metehankk/MeteK-EE463_Project/Case/case.png

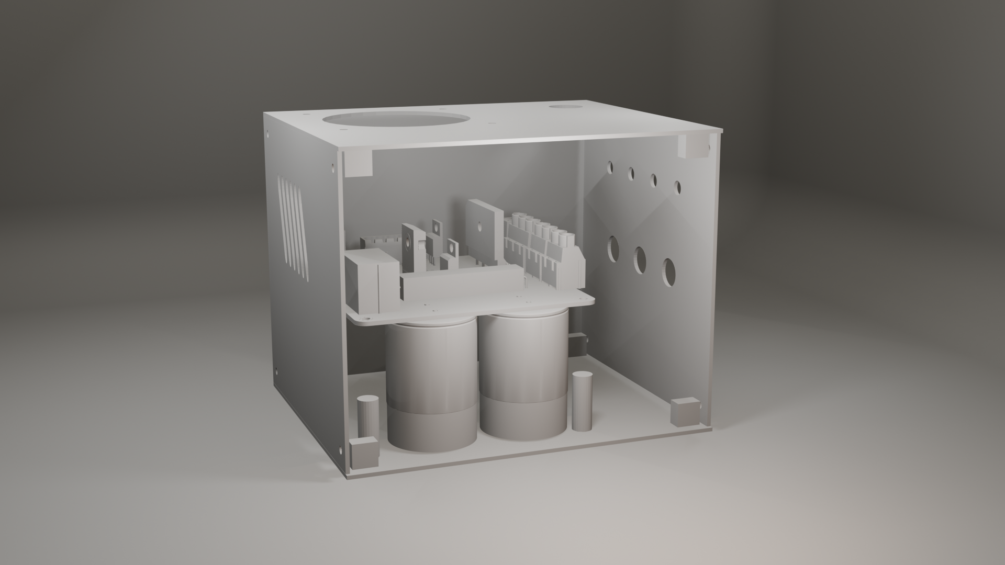
Case/case.png
