metehankk/MeteK-EE463_Project/Reports/Presentation/EE463.pdf

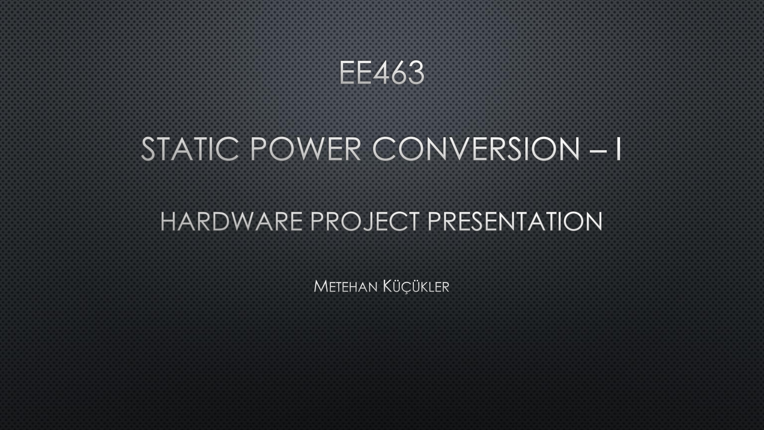
[picture p20: page 1]

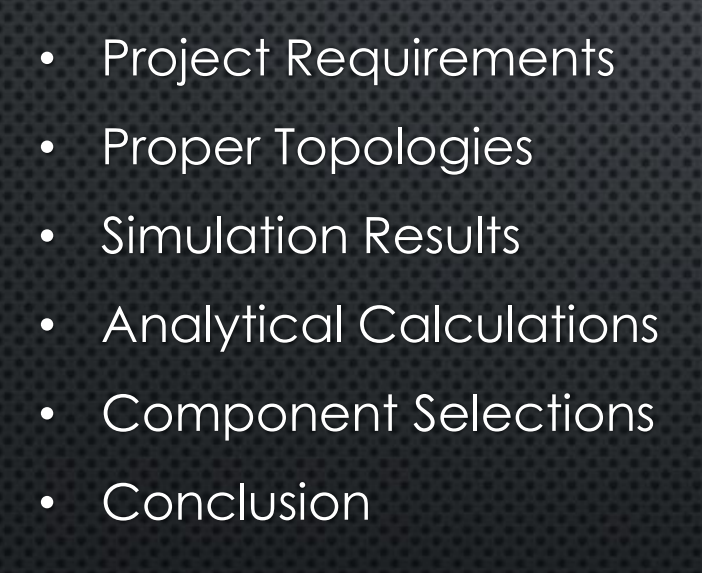
[picture p21: figure]
• Project Requirements; • Proper Topologies; • Simulation Results; • Analytical Calculations; • Component Selections; • Conclusion
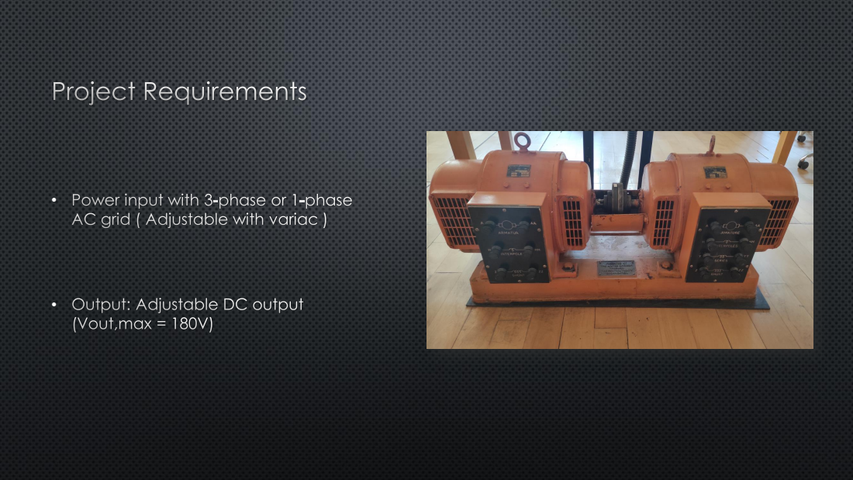
[picture p22: page 3]

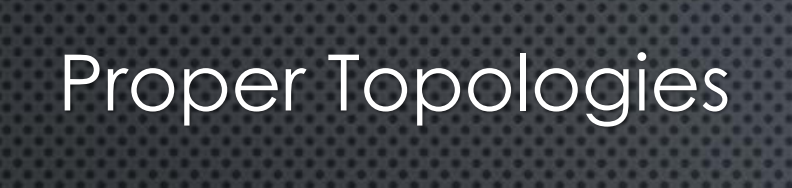
[picture p23: figure]
Proper Topologies
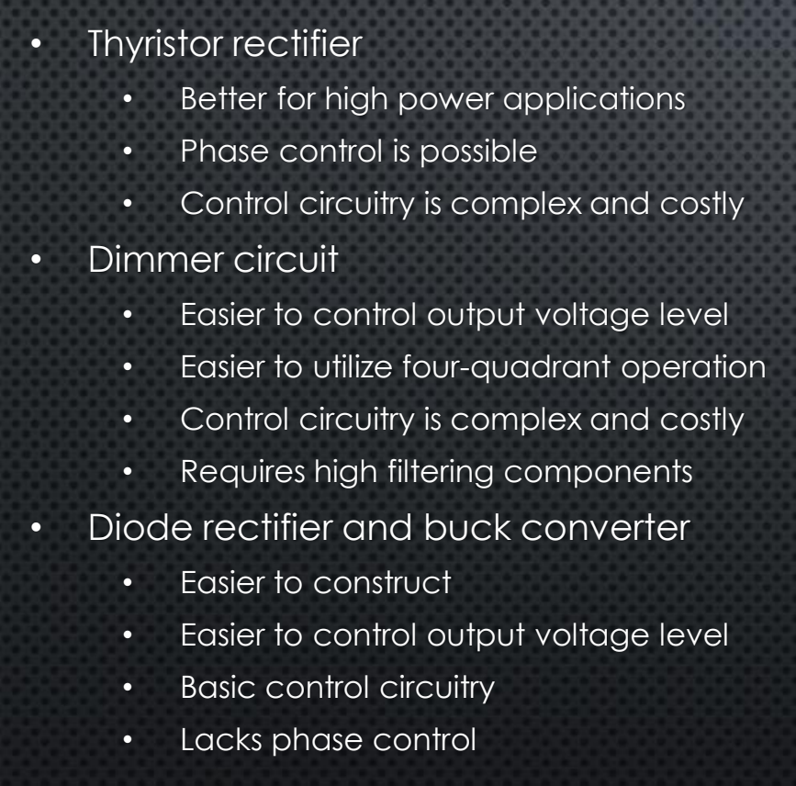
[picture p24: figure]
• Thyristor rectifier; • Better for high power applications; • Phase control is possible; • Dimmer circuit; • Requires high filtering components; • Diode rectifier and buck converter; • Easier to construct; • Basic control circuitry; • Lacks phase control

- Control circuitry is complex and costly
- Easier to control output voltage level
- Easier to utilize four-quadrant operation
- Control circuitry is complex and costly
- Easier to control output voltage level

## Selected Topology

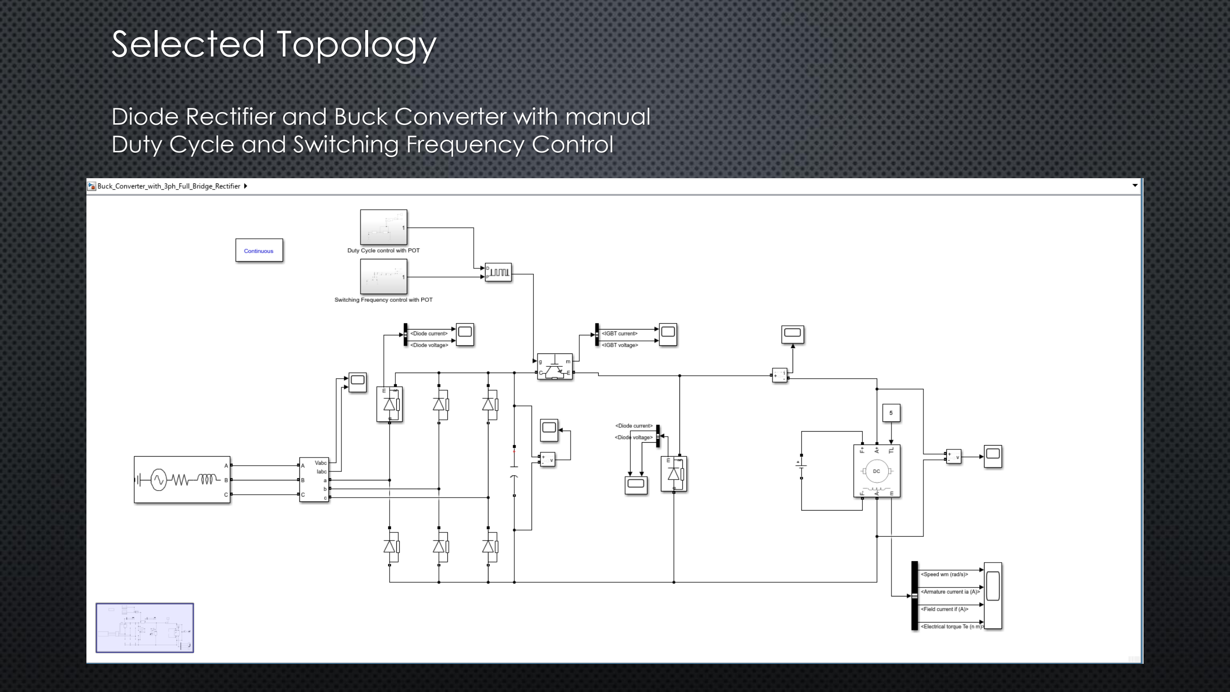
[picture p25: page 5]

Diode Rectifier and Buck Converter with manual Duty Cycle and Switching Frequency Control

## Simulation Results(with RL load)

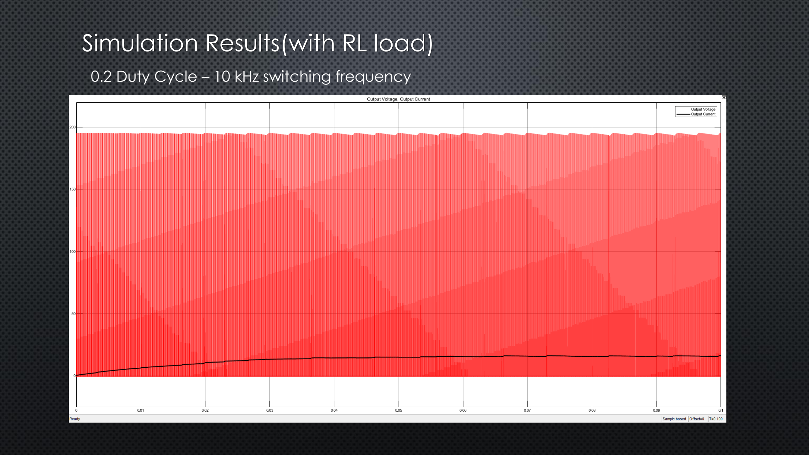
[picture p26: page 6]

0.2 Duty Cycle – 10 kHz switching frequency

## Simulation Results(with RL load)

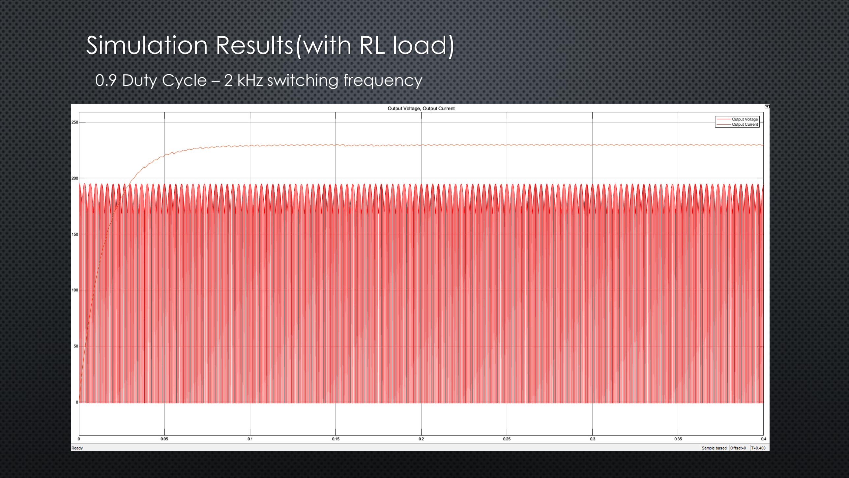
[picture p27: page 7]

0.9 Duty Cycle – 2 kHz switching frequency

## Analytical Calculations

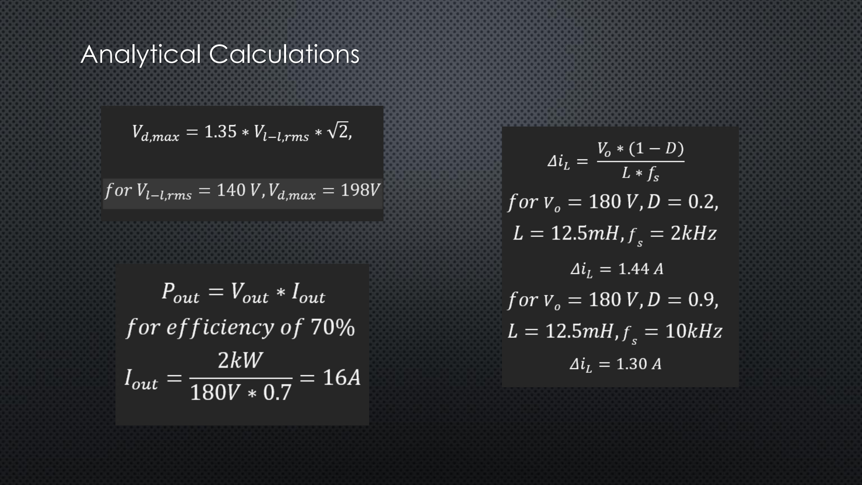
[picture p28: page 8]

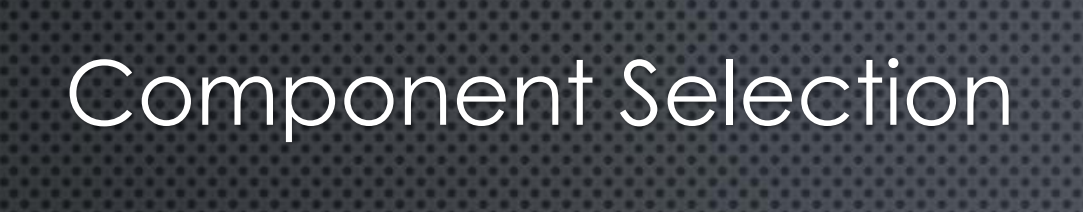
[picture p29: figure]
Component Selection

IGBT | >400V | >25A
RECTIFIER | >400V | >25A
CAPACITOR | 400V | 3 x 470μF
POTENTIOMETER | | 1-100kΩ
Fast Diode | >400V | >25A

Microcontroller Raspberry Pi Pico

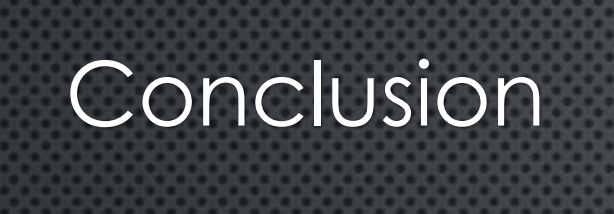
[picture p30: figure]
Conclusion

- Testing
- Integration
- PCB Design
