metehankk/MeteK-EE463_Project/Reports/Final report/Figures/cap.png

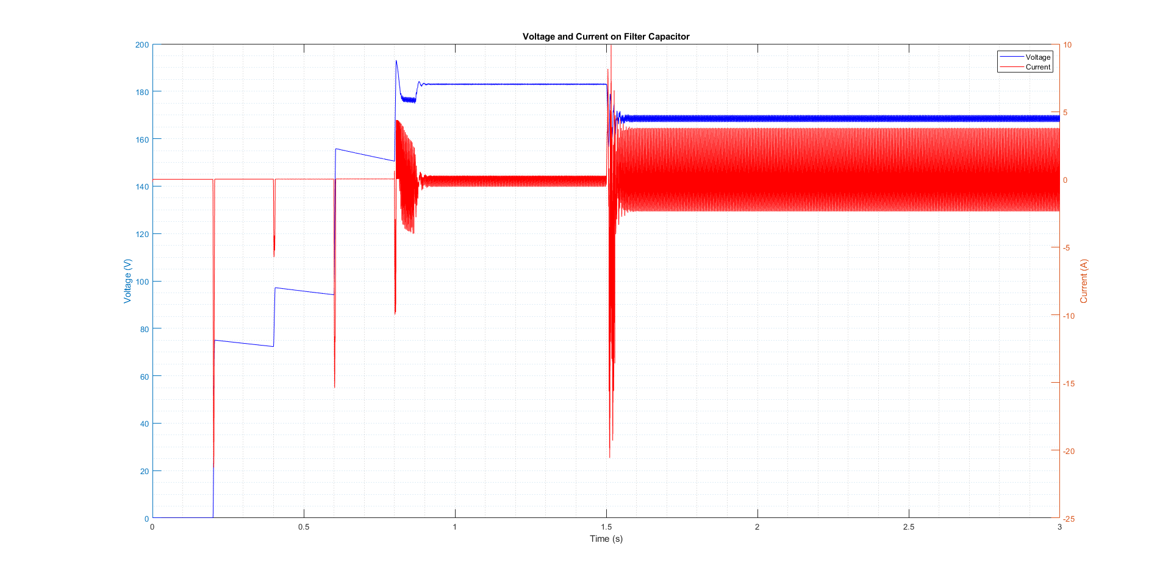
Reports/Final report/Figures/cap.png
