metehankk/MeteK-EE463_Project/Reports/Final report/Figures/fwdiode.png

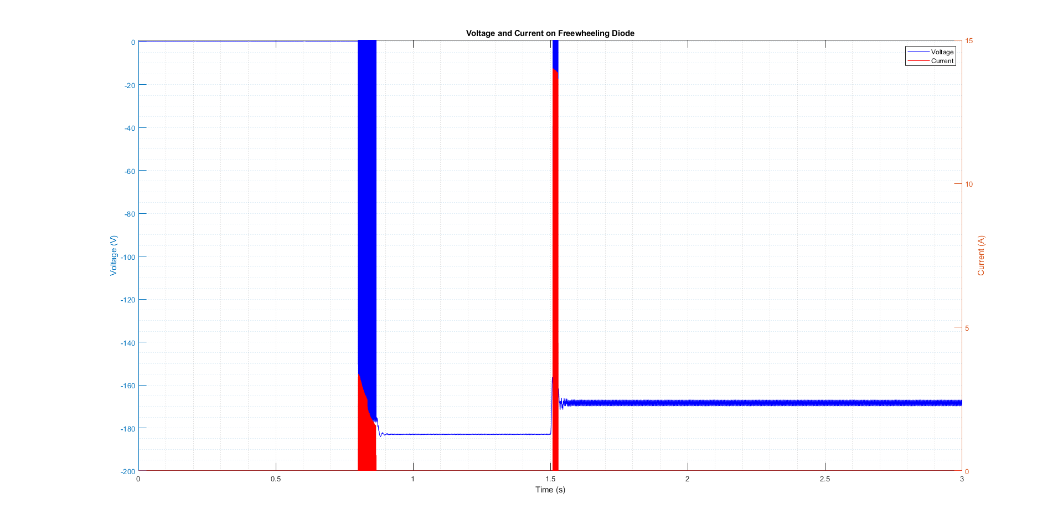
Reports/Final report/Figures/fwdiode.png
