metehankk/MeteK-EE463_Project/Reports/Final report/Figures/igbt.png

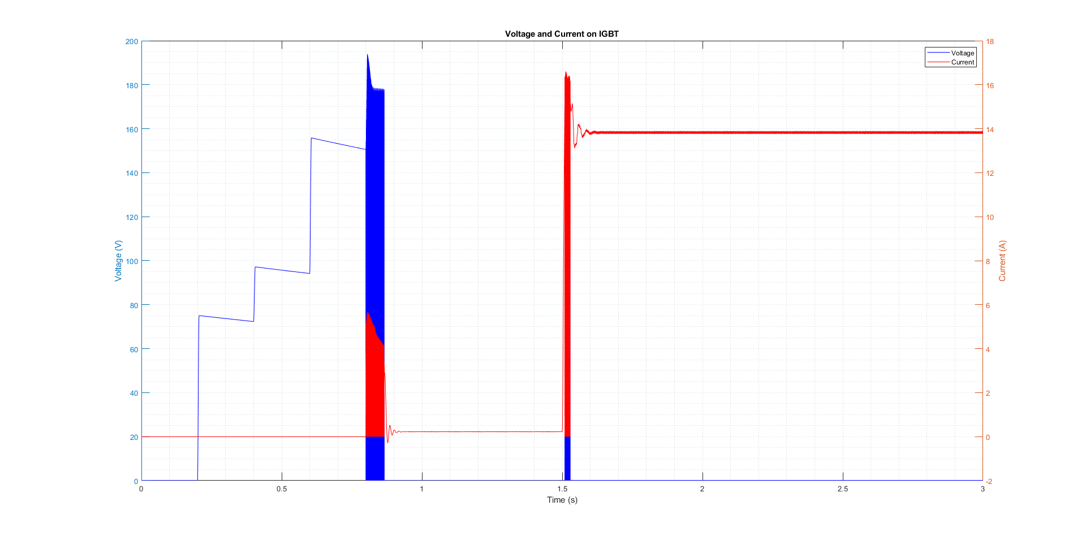
Reports/Final report/Figures/igbt.png
