metehankk/MeteK-EE463_Project/Reports/Final report/Figures/input.png

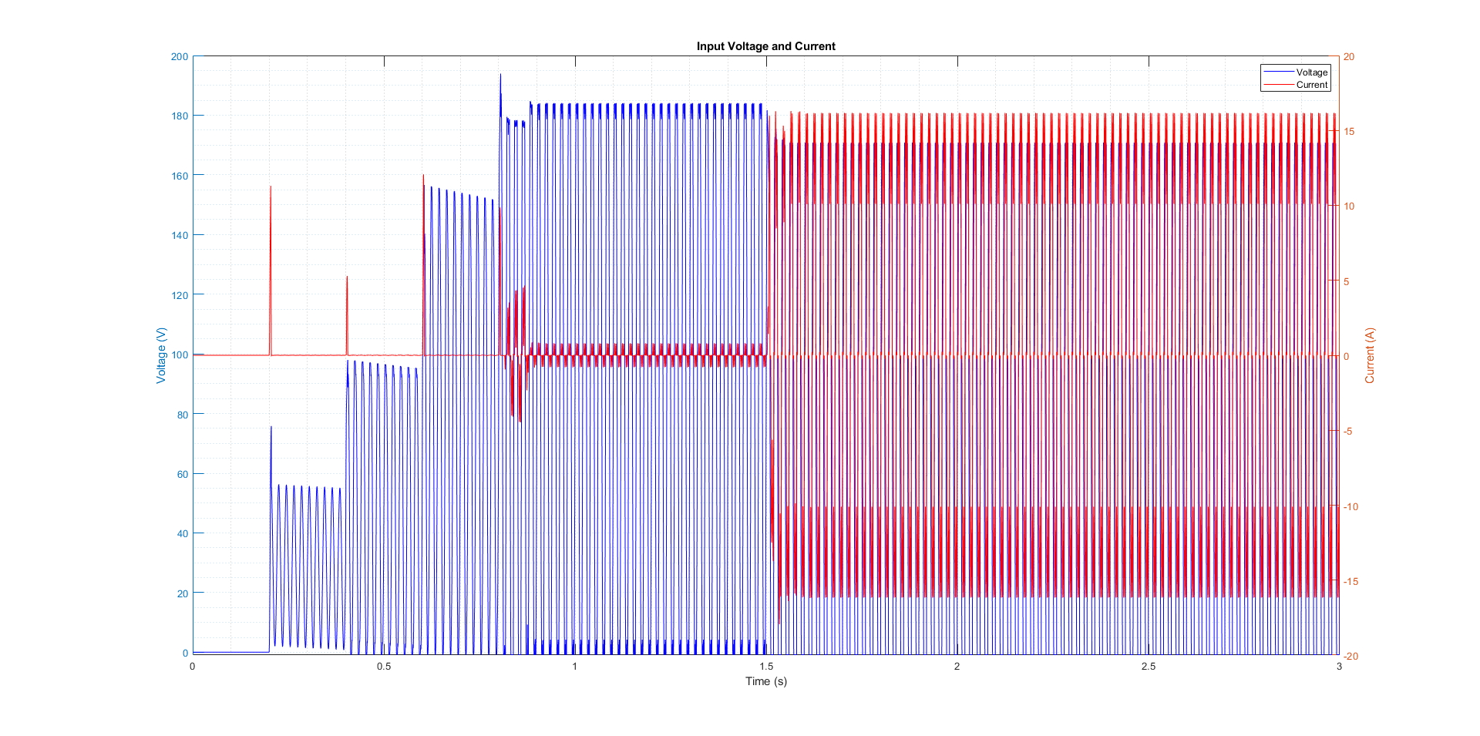
Reports/Final report/Figures/input.png
