metehankk/MeteK-EE463_Project/Reports/Final report/Figures/inputss.png

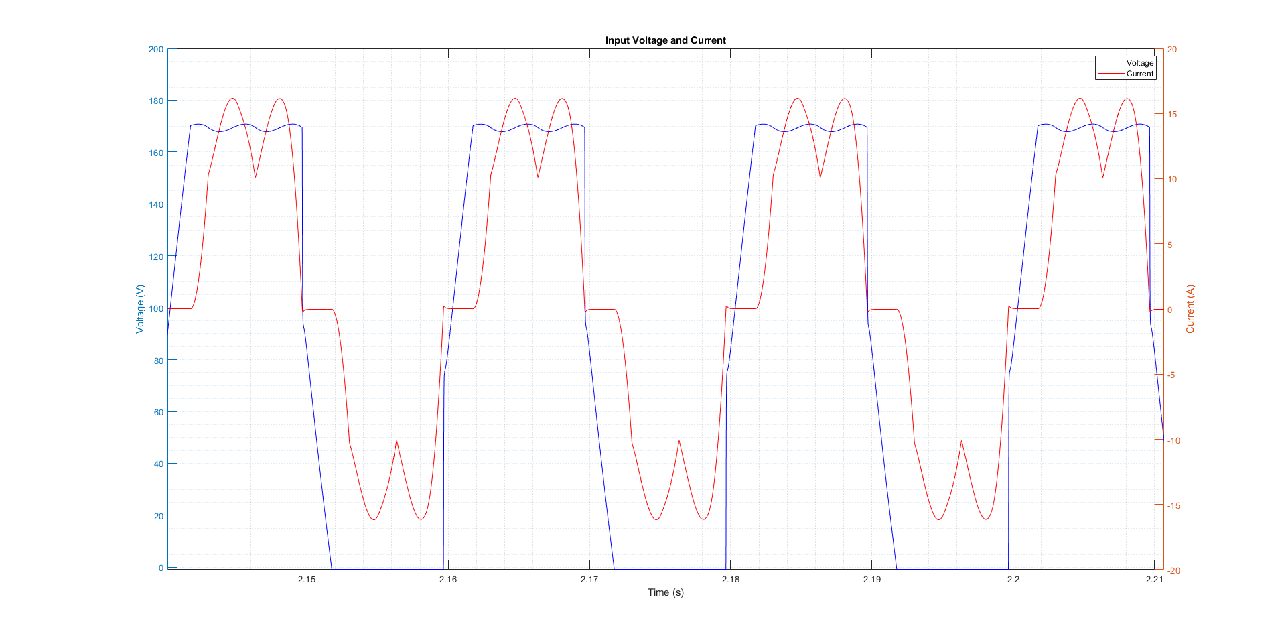
Reports/Final report/Figures/inputss.png
