metehankk/MeteK-EE463_Project/Reports/Final report/Figures/machine.png

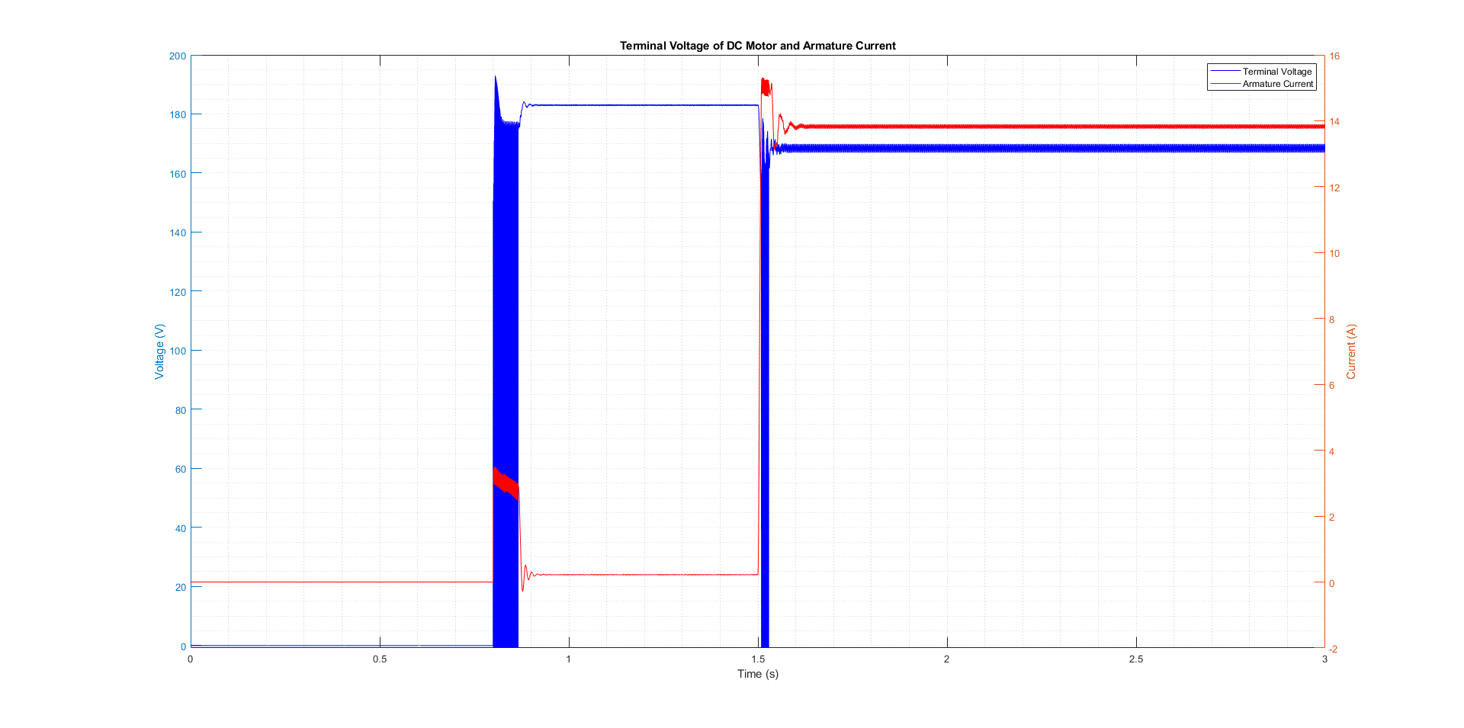
Reports/Final report/Figures/machine.png
