metehankk/MeteK-EE463_Project/Reports/Final report/Figures/machiness.png

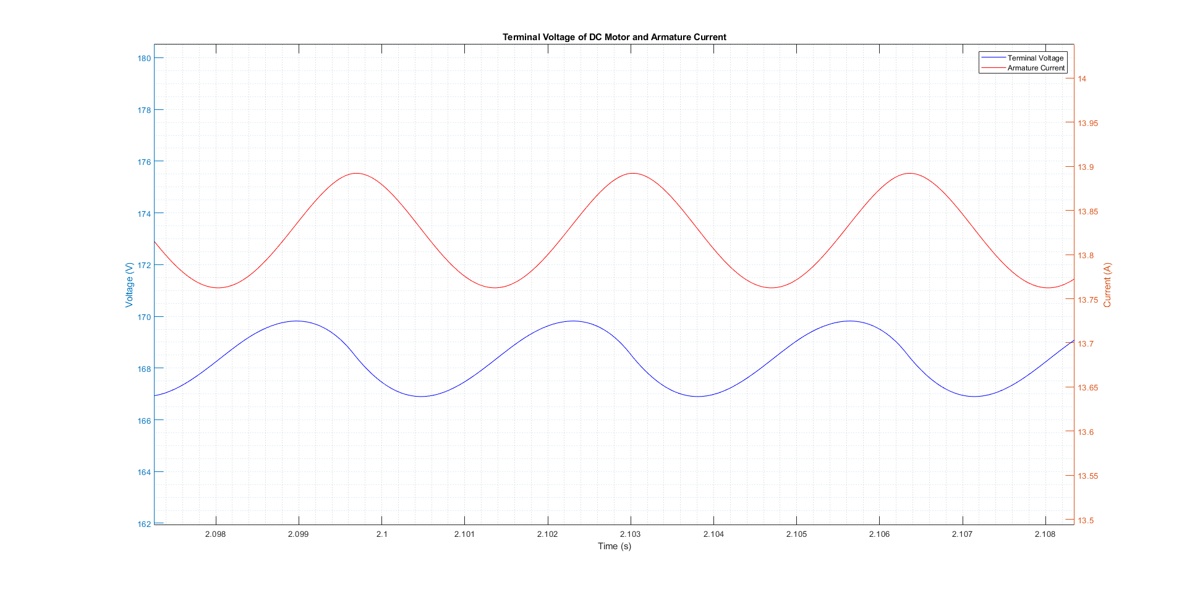
Reports/Final report/Figures/machiness.png
