metehankk/MeteK-EE463_Project/Reports/Final report/Figures/rec.png

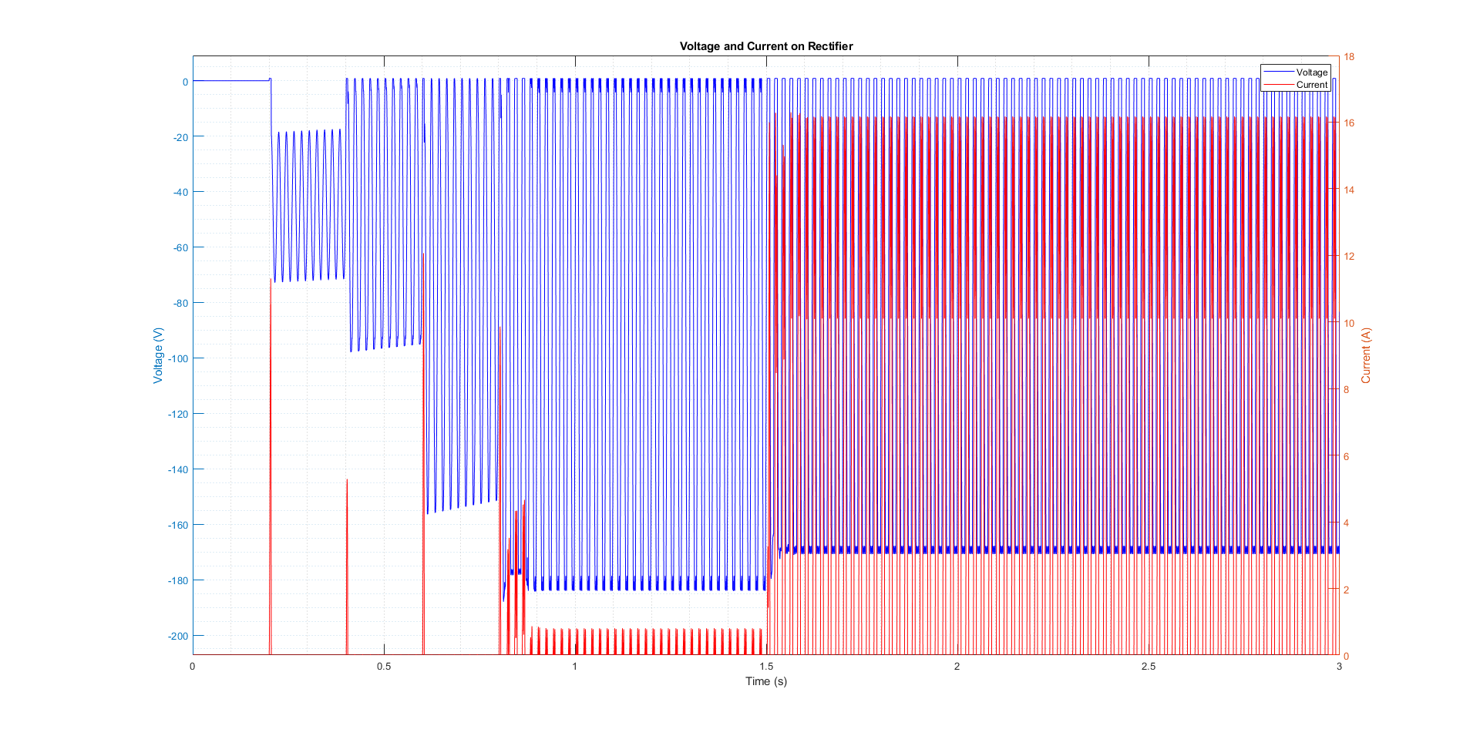
Reports/Final report/Figures/rec.png
