metehankk/MeteK-EE463_Project/Reports/Final report/Figures/speed.png

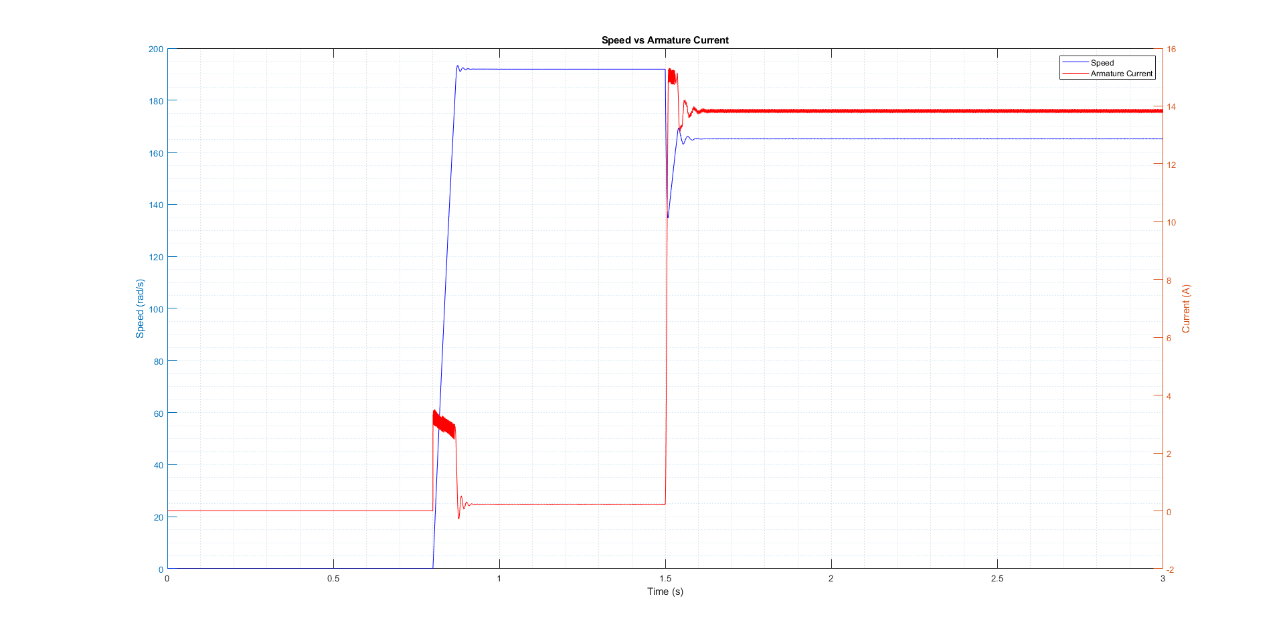
Reports/Final report/Figures/speed.png
