metehankk/MeteK-EE463_Project/Reports/Final report/Figures/speedss.png

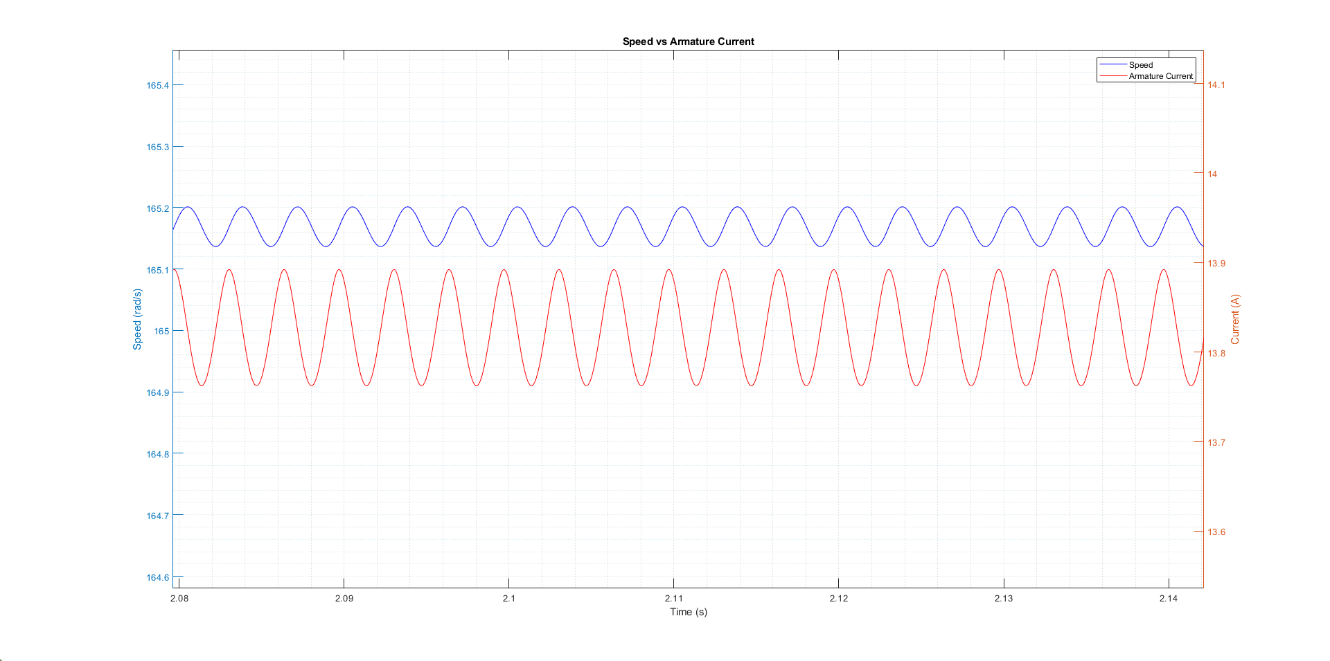
Reports/Final report/Figures/speedss.png
