metehankk/MeteK-EE463_Project/Reports/Presentation/Presentation-report-figures/Output-with-20D-10kHz.png

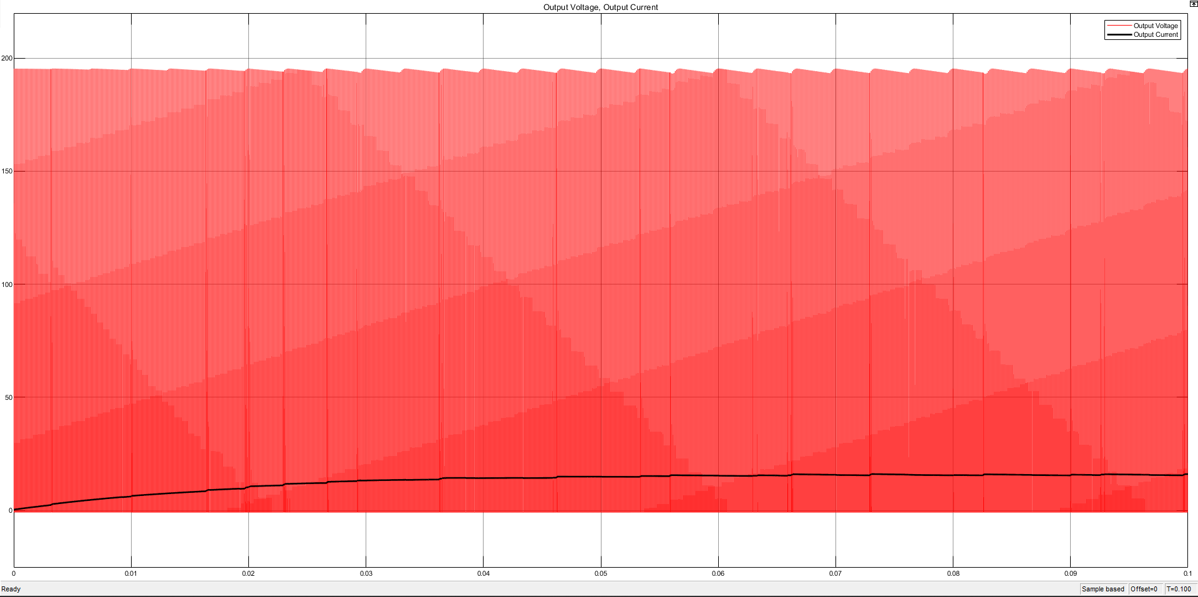
Reports/Presentation/Presentation-report-figures/Output-with-20D-10kHz.png
