metehankk/MeteK-EE463_Project/Reports/Presentation/Presentation-report-figures/Output-with-90D-2kHz.png

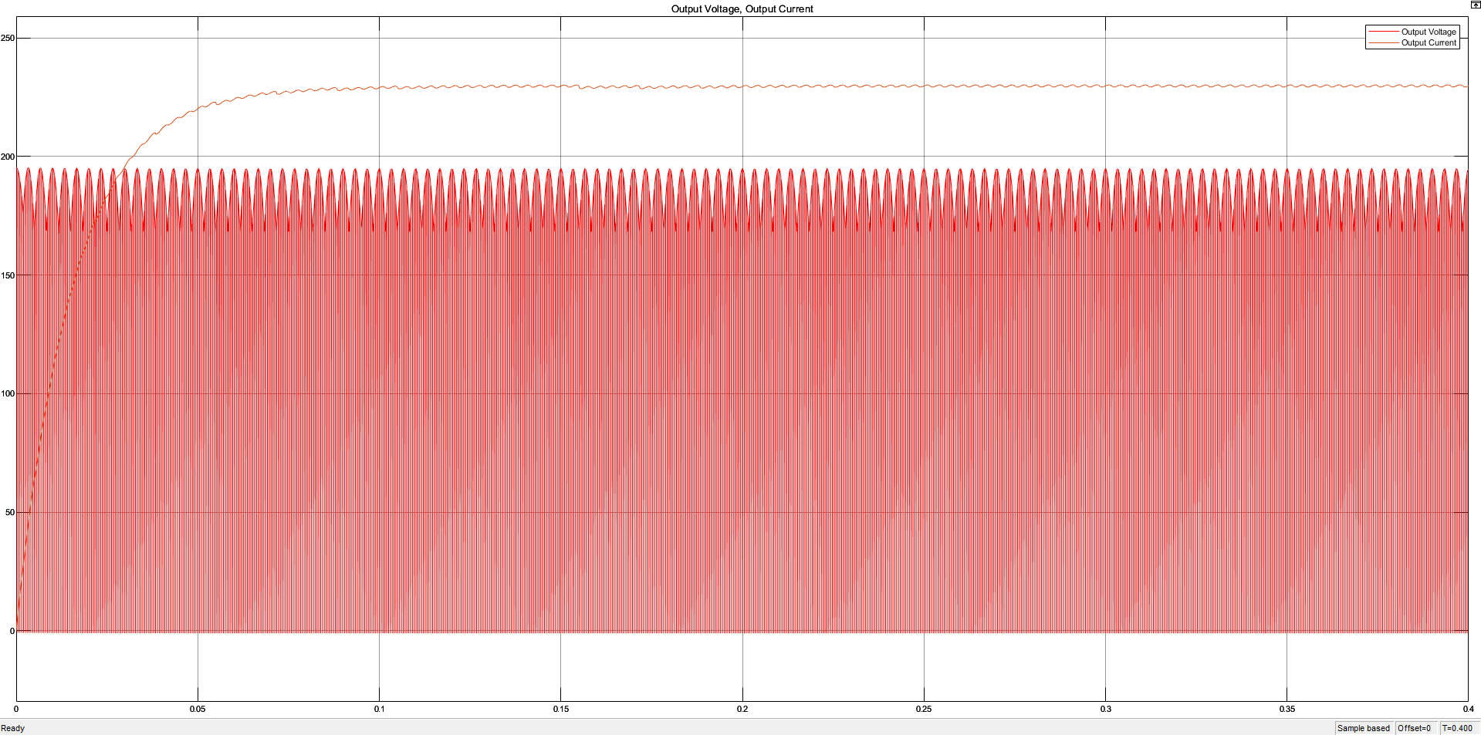
Reports/Presentation/Presentation-report-figures/Output-with-90D-2kHz.png
