metehankk/MeteK-EE463_Project/Reports/Simulation report/Simulation-report-figures/duty-cycle-cotrol.png

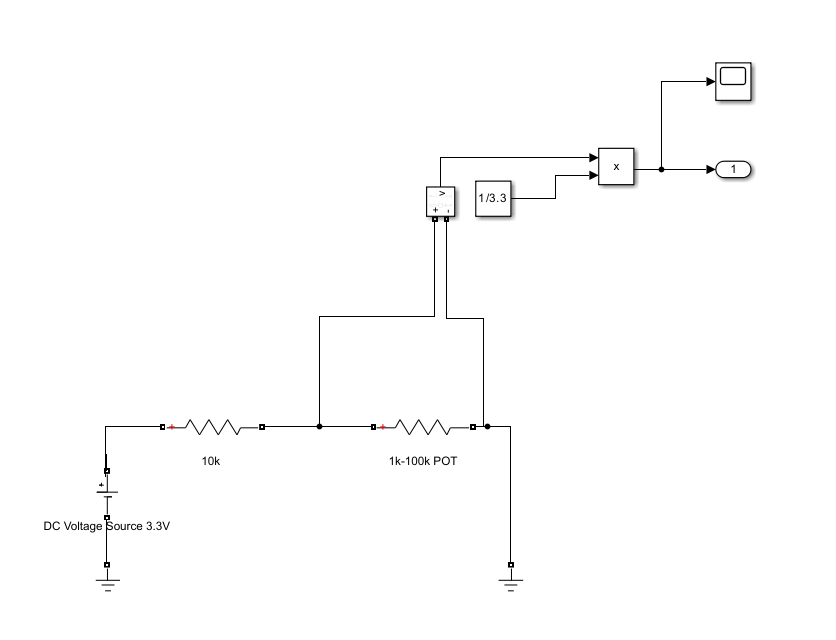
Reports/Simulation report/Simulation-report-figures/duty-cycle-cotrol.png
