metehankk/MeteK-EE463_Project/Reports/Simulation report/Simulation-report-figures/frequency-control.png

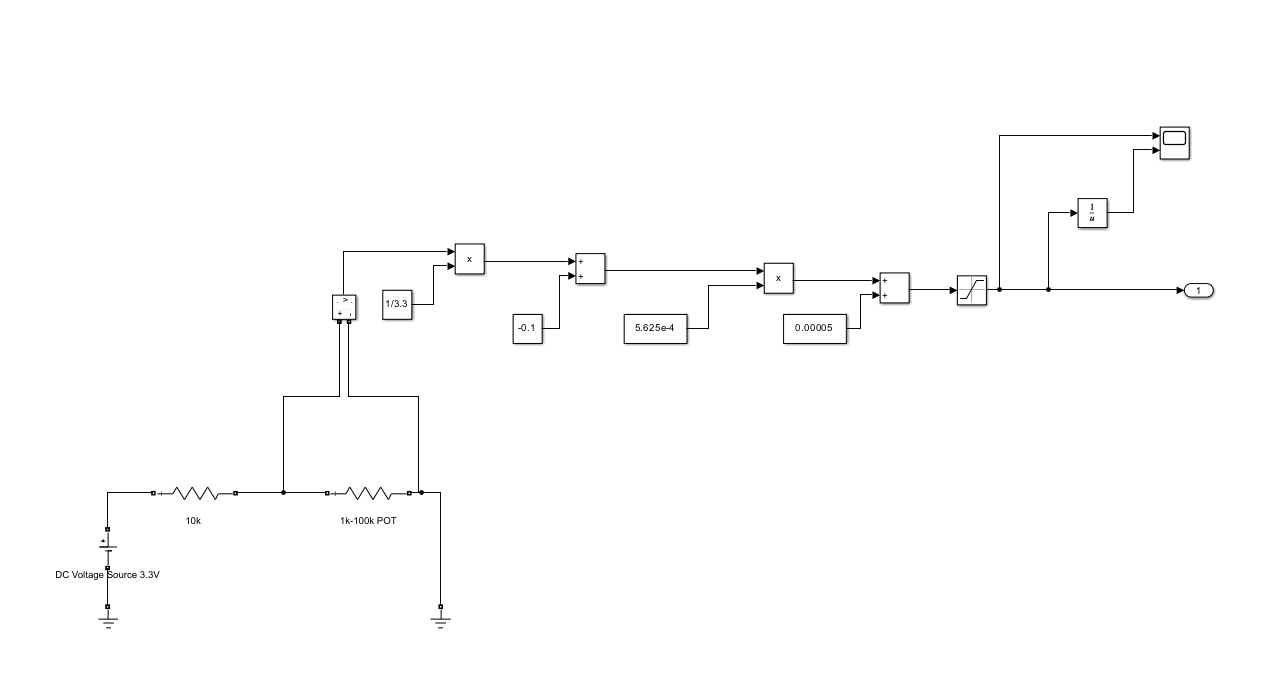
Reports/Simulation report/Simulation-report-figures/frequency-control.png
