metehankk/MeteK-EE463_Project/Reports/Simulation report/Simulation-report-figures/schematic-with-freq-and-d-control.png

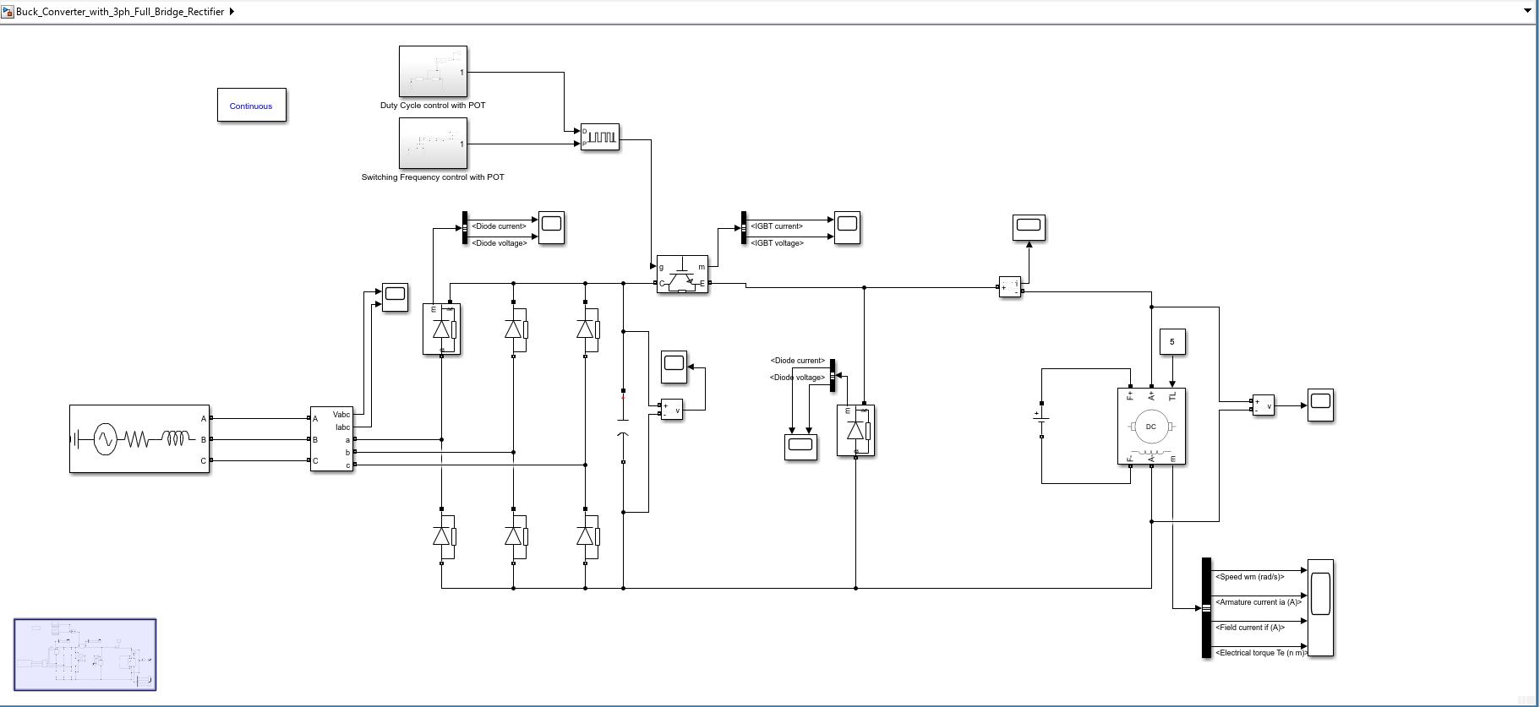
Reports/Simulation report/Simulation-report-figures/schematic-with-freq-and-d-control.png
