metehankk/MeteK-EE463_Project/Case/stl-exports/top.stl

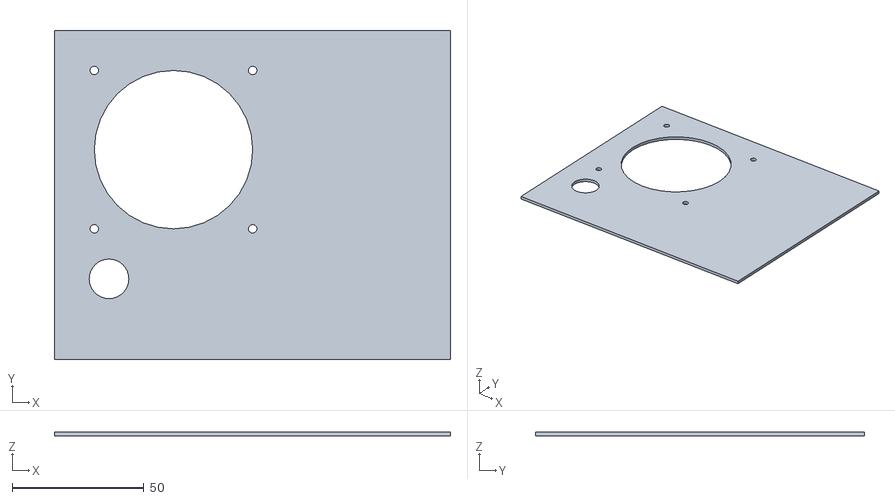
[picture p46: CAD file, 2023-01-24]
Case/stl-exports/top.stl
150.0 x 124.7 x 1.60
