metehankk/MeteK-EE463_Project/Case/stl-exports/pcb-mount.stl

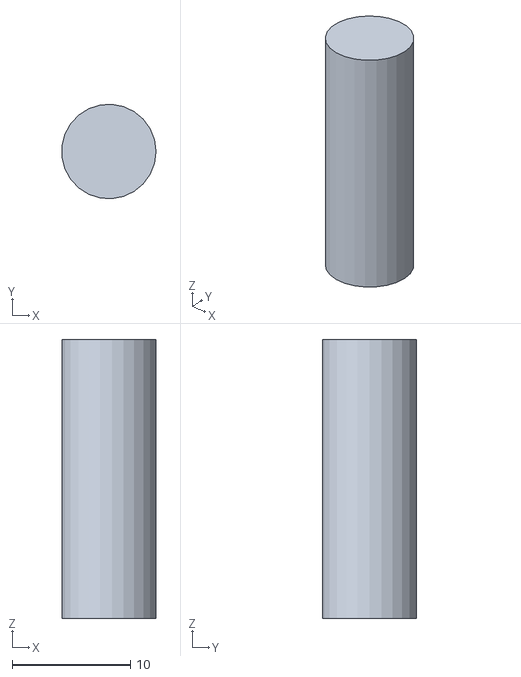
[picture p47: CAD file, 2023-01-05]
Case/stl-exports/pcb-mount.stl
7.97 x 7.98 x 23.6
