metehankk/MeteK-EE463_Project/Case/stl-exports/front.stl

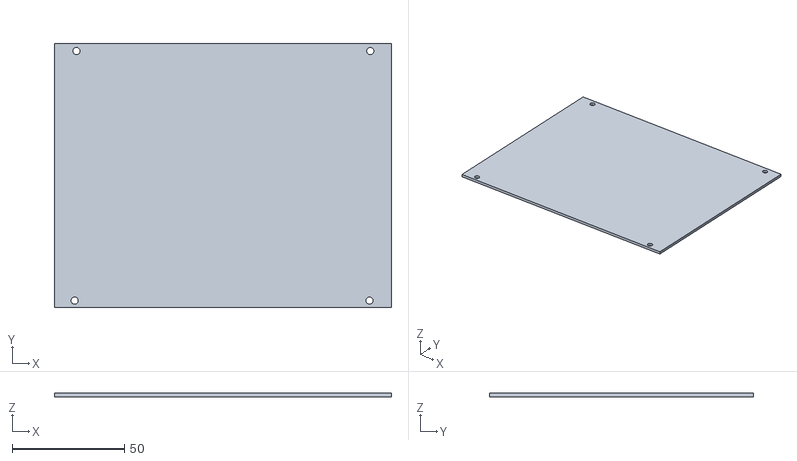
[picture p48: CAD file, 2023-01-05]
Case/stl-exports/front.stl
150.0 x 117.6 x 1.60
