metehankk/MeteK-EE463_Project/Case/stl-exports/right.stl

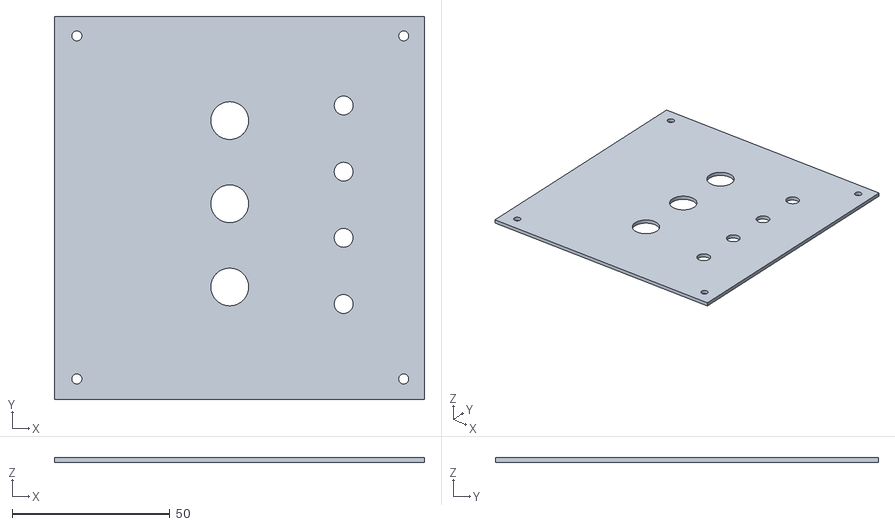
[picture p49: CAD file, 2023-01-05]
Case/stl-exports/right.stl
117.6 x 121.5 x 1.60
