metehankk/MeteK-EE463_Project/Case/stl-exports/bottom.stl

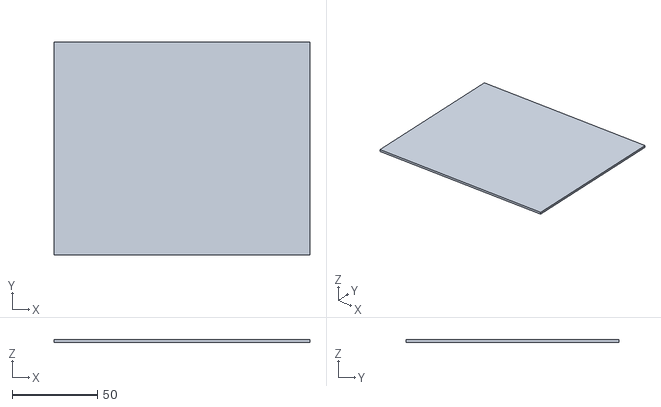
[picture p50: CAD file, 2023-01-05]
Case/stl-exports/bottom.stl
150.0 x 124.7 x 1.60
