metehankk/MeteK-EE463_Project/Case/stl-exports/cubes.stl

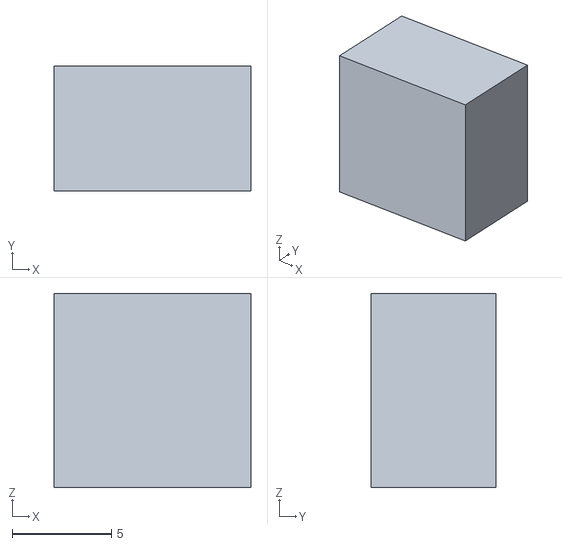
[picture p51: CAD file, 2023-01-05]
Case/stl-exports/cubes.stl
9.93 x 6.28 x 9.78
