metehankk/MeteK-EE463_Project/Case/stl-exports/left.stl

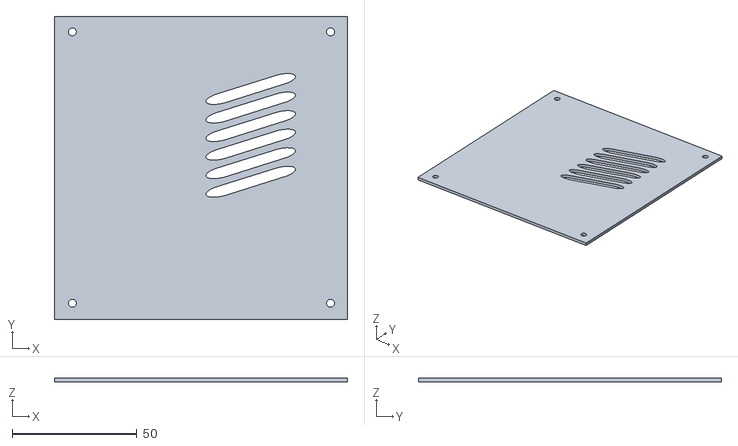
[picture p52: CAD file, 2023-01-05]
Case/stl-exports/left.stl
117.6 x 121.5 x 1.60
