metehankk/MeteK-EE463_Project/(list of files, cad)

Other CAD files:
Case/stl-exports/back.stl
