metehankk/MeteK-EE463_Project/Schematic/MeteK/v3/v3.pdf

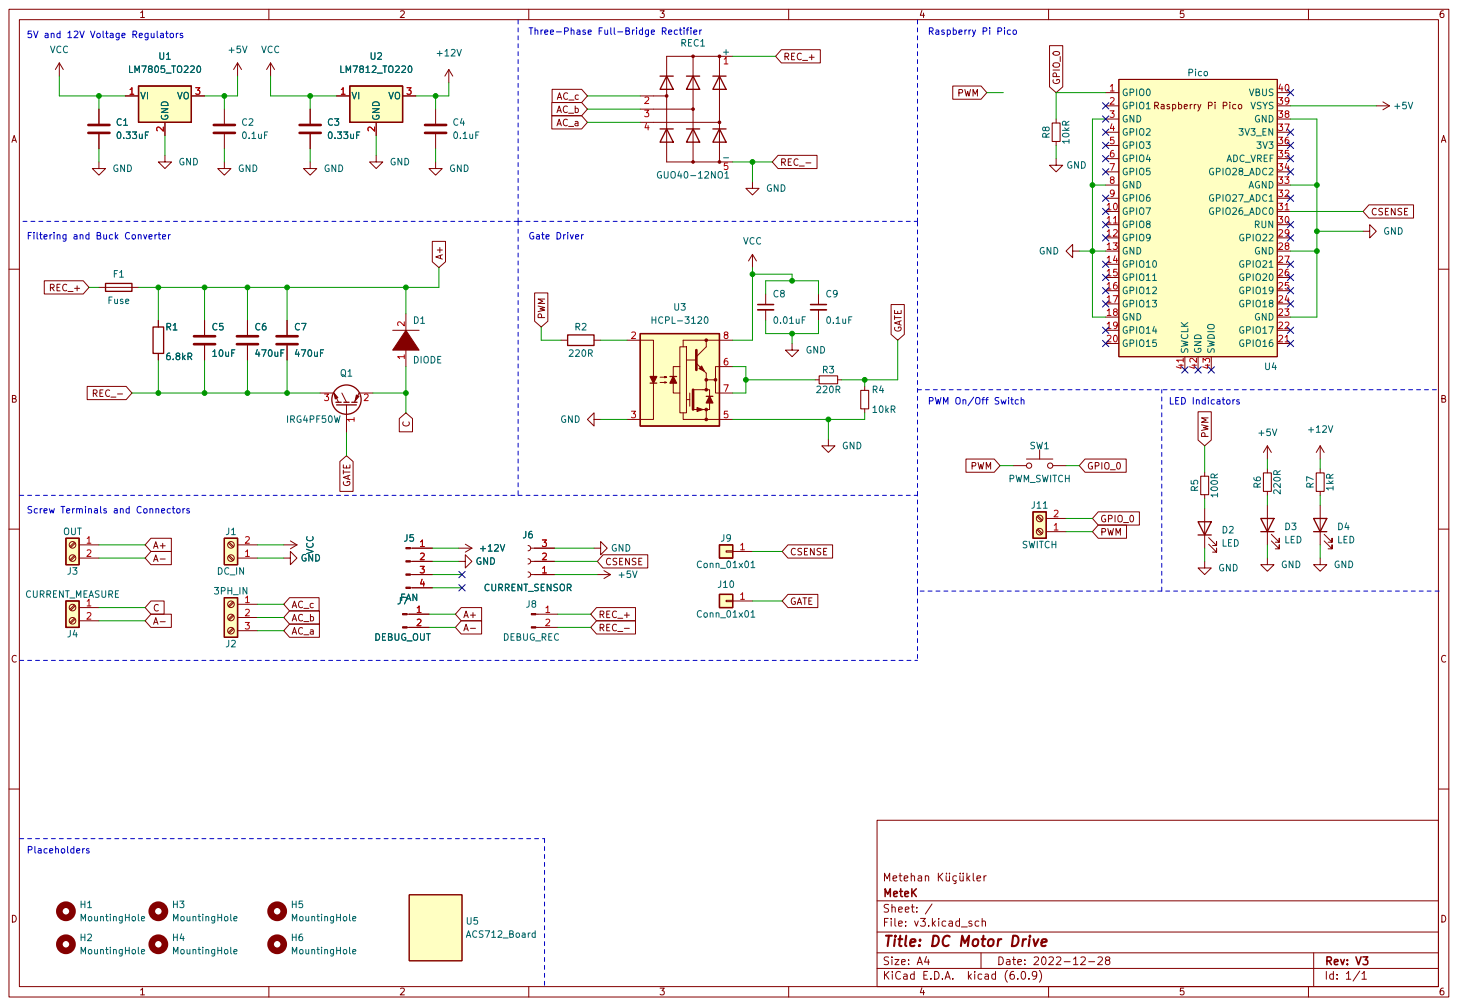
[picture p53: page 1]

Raspberry Pi Pico PWM On/Off Switch Placeholders

Id: 1/1 Title: DC Motor Drive
