metehankk/MeteK-EE463_Project/Tests/ltspice/combined-schematic.asc

C1: cap; 0.1µ; V=10 Irms=0 Rser=0.0163 Lser=375p mfg="Würth Elektronik" pn="885012207016 WCAP-CSGP 0805" type="X7R"
C2: cap; 0.33µ
C4: cap; 0.01µ; V=25 Irms=0 Rser=0.0262 Lser=534p mfg="Würth Elektronik" pn="885012008030 WCAP-CSGP 1206" type="NP0"
C5: cap; 0.1µ; V=50 Irms=0 Rser=0.0808 Lser=1.08n mfg="Würth Elektronik" pn="885382208003 WCAP-CSST 1206" type="X7R"
C6: polcap; 950µ; V=450 Irms=10 Rser=0.01 Lser=8n
C8: cap; 0.33µ
C9: cap; 0.1µ
D1: diode
D2: diode
D3: diode
D4: diode
D5: diode
D6: diode
D7: diode
L1: ind; 12.5m
L2: ind; 10µ
L3: ind; 10µ
L4: ind; 10µ
R1: res; 0.8
R2: res; 220
R3: res; 1000k
R4: res; 6.8k
R6: res; 10k
R7: res; 171
R8: res; 1
R9: res; 0.001
R10: res; 220
R12: res; 1
R13: res; 0.001
R14: res; 0.001
R15: res; 66
U1: LM7805-1
U2: IGBT_ST
U3: HCPL-3120
U4: LM7812
V1: voltage; 4.5
V3: voltage; PULSE(0 3.3 1n 1n 1n 0.1m 0.5m)
V5: voltage; 18
V7: voltage; SINE(0 109 50)
V8: voltage; SINE(0 109 50 0 0 -120)
V9: voltage; SINE(0 109 50 0 0 120)
Named nets: 18V, 5V, 3V3_PWM, Opto_Signal, REC+, A+, A-, CSENSE, 12V, REC-, 0
Voltage regulator - 5V
Isolated gate driver
Buck converter test
Test inputs
Three phase full bridge rectifier
Pico model 
for low power 
operation
CSENSE is analog voltages between 2.5V and 4.5V.
While current is zero it gives 2.5V analog voltage signal
and it increases with 66mV/A.
Voltage regulator - 12V
.tran 0 60m 0 50u
