metehankk/MeteK-EE463_Project/Tests/ltspice/hcpl3120-test.asc

C1: polcap; 1000µ; V=400 Irms=2.85 Rser=0.0839 Lser=14.3n mfg="Würth Elektronik" pn="861021386035 WCAP-AIG5 35x60" type="Al electrolytic"
C2: cap; 0.1µ; V=25 Irms=0 Rser=0.0189 Lser=443p mfg="Würth Elektronik" pn="885012206071R WCAP-CSGP 0603" type="X7R"
C3: cap; 10µ; V=25 Irms=0 Rser=0.0024 Lser=877p mfg="Würth Elektronik" pn="885012109013 WCAP-CSGP 1210" type="X5R"
C4: cap; 0.01µ; V=500 Irms=0 Rser=0.0478 Lser=358p mfg="Würth Elektronik" pn="885342207014 WCAP-CSMH 0805" type="X7R"
D1: diode; RFUH20NS4S
L1: ind; 1m
M1: nmos; STN3N45K3
R1: res; 0.8
R2: res; 220
R4: res; 1k
R5: res; 10
U2: HCPL-3120
V1: voltage; PULSE(0 3.3 1n 1n 1n 0.9m 1m)
V2: voltage; 180
V3: voltage; 18
Named nets: 0
.tran 0 200m 0 10u
