metehankk/MeteK-EE463_Project/Tests/ltspice/current-sensing-with-opamp.asc

R1: res; 18k
R2: res; 1k
R5: res; 0.005
R6: res; 0.8
R7: res; 100
U1: UniversalOpAmp
V1: voltage; 20
V2: voltage; -12
V3: voltage; 12
Named nets: 0
.tran 0 1 0 10u
