metehankk/MeteK-EE463_Project/Schematic/MeteK/v3/v3.kicad_pcb

## KiCad design Schematic/MeteK/v3/v3.kicad_pcb (2022-12-28)

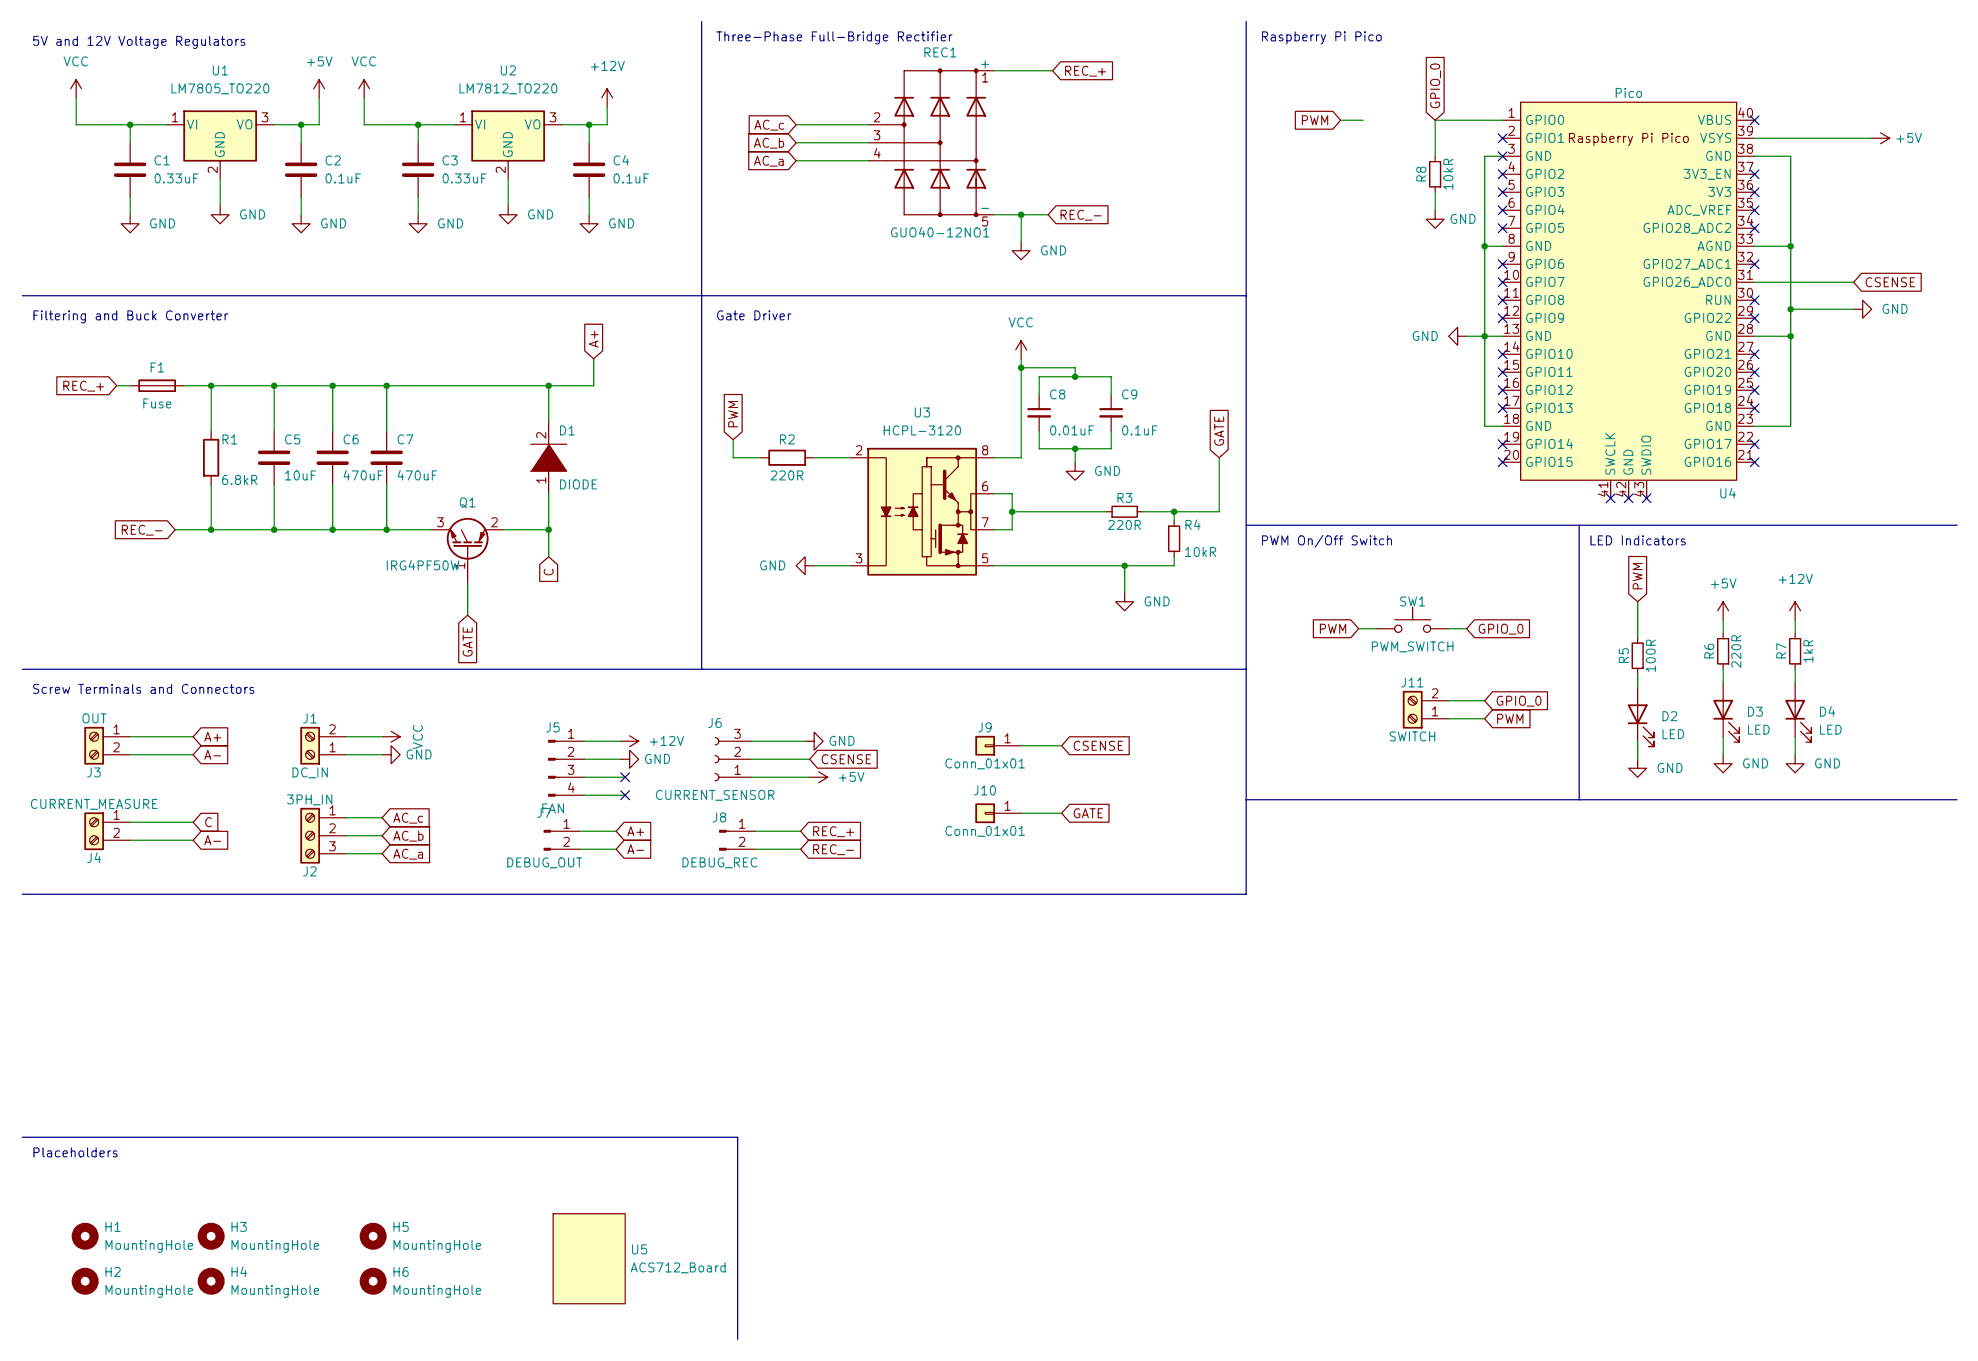
[picture p54: schematic v3.kicad_sch, DC Motor Drive]

Parts:
C1, C3: 0.33uF; C_1206_3216Metric_Pad1.33x1.80mm_HandSolder
C2, C4: 0.1uF; C_1206_3216Metric_Pad1.33x1.80mm_HandSolder
C5: 10uF; C_Rect_L29.0mm_W16.0mm_P27.50mm_MKT
C6, C7: 470uF; CP_Radial_D35.0mm_H50.0mm_P10.00mm_SnapIn
C8: 0.01uF; C_1206_3216Metric
C9: 0.1uF; C_1206_3216Metric
D1: DIODE; TO-220-2_Vertical
D2, D3, D4: LED; LED_D3.0mm
F1: Fuse; Fuseholder_Clip-5x20mm_Bel_FC-203-22_Lateral_P17.80x5.00mm_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
H1, H2, H3, H4: MountingHole; MountingHole_3.2mm_M3_Pad_Via
H5, H6: MountingHole; MountingHole_2.1mm
J1: DC_IN; TerminalBlock_Phoenix_MKDS-3-2-5.08_1x02_P5.08mm_Horizontal
J2: 3PH_IN; P7.62mm_ScrewTerminal_01x03
J3: OUT; P7.62mm_ScrewTerminal_01x02
J4: CURRENT_MEASURE; P7.62mm_ScrewTerminal_01x02
J5: FAN; PhoenixContact_MSTBVA_2,5_4-G-5,08_1x04_P5.08mm_Vertical
J6: CURRENT_SENSOR; PinSocket_1x03_P2.54mm_Vertical
J7: DEBUG_OUT; PinHeader_1x02_P2.54mm_Vertical
J8: DEBUG_REC; PinHeader_1x02_P2.54mm_Vertical
J9, J10: Conn_01x01; PinHeader_1x01_P2.54mm_Vertical
J11: SWITCH; TerminalBlock_Phoenix_MPT-0,5-2-2.54_1x02_P2.54mm_Horizontal
Q1: IRG4PF50W; TO-247-3_Vertical
R1: 6.8kR; R_Axial_Power_L50.0mm_W9.0mm_P55.88mm
R2, R3, R6: 220R; R_1206_3216Metric_Pad1.30x1.75mm_HandSolder
R4, R8: 10kR; R_1206_3216Metric_Pad1.30x1.75mm_HandSolder
R5: 100R; R_1206_3216Metric_Pad1.30x1.75mm_HandSolder
R7: 1kR; R_1206_3216Metric_Pad1.30x1.75mm_HandSolder
REC1: GUO40-12NO1; Diode_Bridge_IXYS_GUFP
SW1: PWM_SWITCH
U1: LM7805_TO220; TO-220-3_Vertical
U2: LM7812_TO220; TO-220-3_Vertical
U3: HCPL-3120; DIP-8_W7.62mm
U4: Pico; RPi_Pico_SMD_TH
U5: ACS712_Board; Current_sensor

Connections:
+5V: C2.1, J6.1, R6.2, U1.3 (VO), U4.39 (VSYS)
+12V: C4.1, J5.1, R7.2, U2.3 (VO)
A+: C5.1, C6.1, C7.1, D1.2 (A), F1.2, J3.1, J7.1, R1.1
A-: J3.2, J4.2, J7.2
AC_a: J2.3, REC1.4
AC_b: J2.2, REC1.3
AC_c: J2.1, REC1.2
C: D1.1 (K), J4.1, Q1.2 (C)
CSENSE: J6.2, J9.1, U4.31 (GPIO26_ADC0)
GATE: J10.1, Q1.1 (G), R3.2, R4.1
GPIO_0: J11.2, R8.2, SW1.2, U4.1 (GPIO0)
unnamed: D2.2 (A), R5.1
unnamed: D3.2 (A), R6.1
unnamed: D4.2 (A), R7.1
unnamed: R2.2, U3.2 (A)
unnamed: R3.1, U3.6 (VO), U3.7 (VO)
PWM: J11.1, R2.1, R5.2, SW1.1
REC_+: F1.1, J8.1, REC1.1 (+)
REC_-: C1.2, C2.2, C3.2, C4.2, C5.2, C6.2, C7.2, C8.2, C9.2, D2.1 (K), D3.1 (K), D4.1 (K), J1.1, J5.2, J6.3, J8.2, Q1.3 (E), R1.2, R4.2, R8.1, REC1.5 (-), U1.2 (GND), U2.2 (GND), U3.3 (C), U3.5 (VEE), U4.3 (GND), U4.8 (GND), U4.13 (GND), U4.18 (GND), U4.23 (GND), U4.28 (GND), U4.33 (AGND), U4.38 (GND)
VCC: C1.1, C3.1, C8.1, C9.1, J1.2, U1.1 (VI), U2.1 (VI), U3.8 (VCC)

Notes on the sheet:
LED Indicators
5V and 12V Voltage Regulators
Gate Driver
PWM On/Off Switch
Placeholders
Three-Phase Full-Bridge Rectifier
Raspberry Pi Pico
Filtering and Buck Converter
Screw Terminals and Connectors

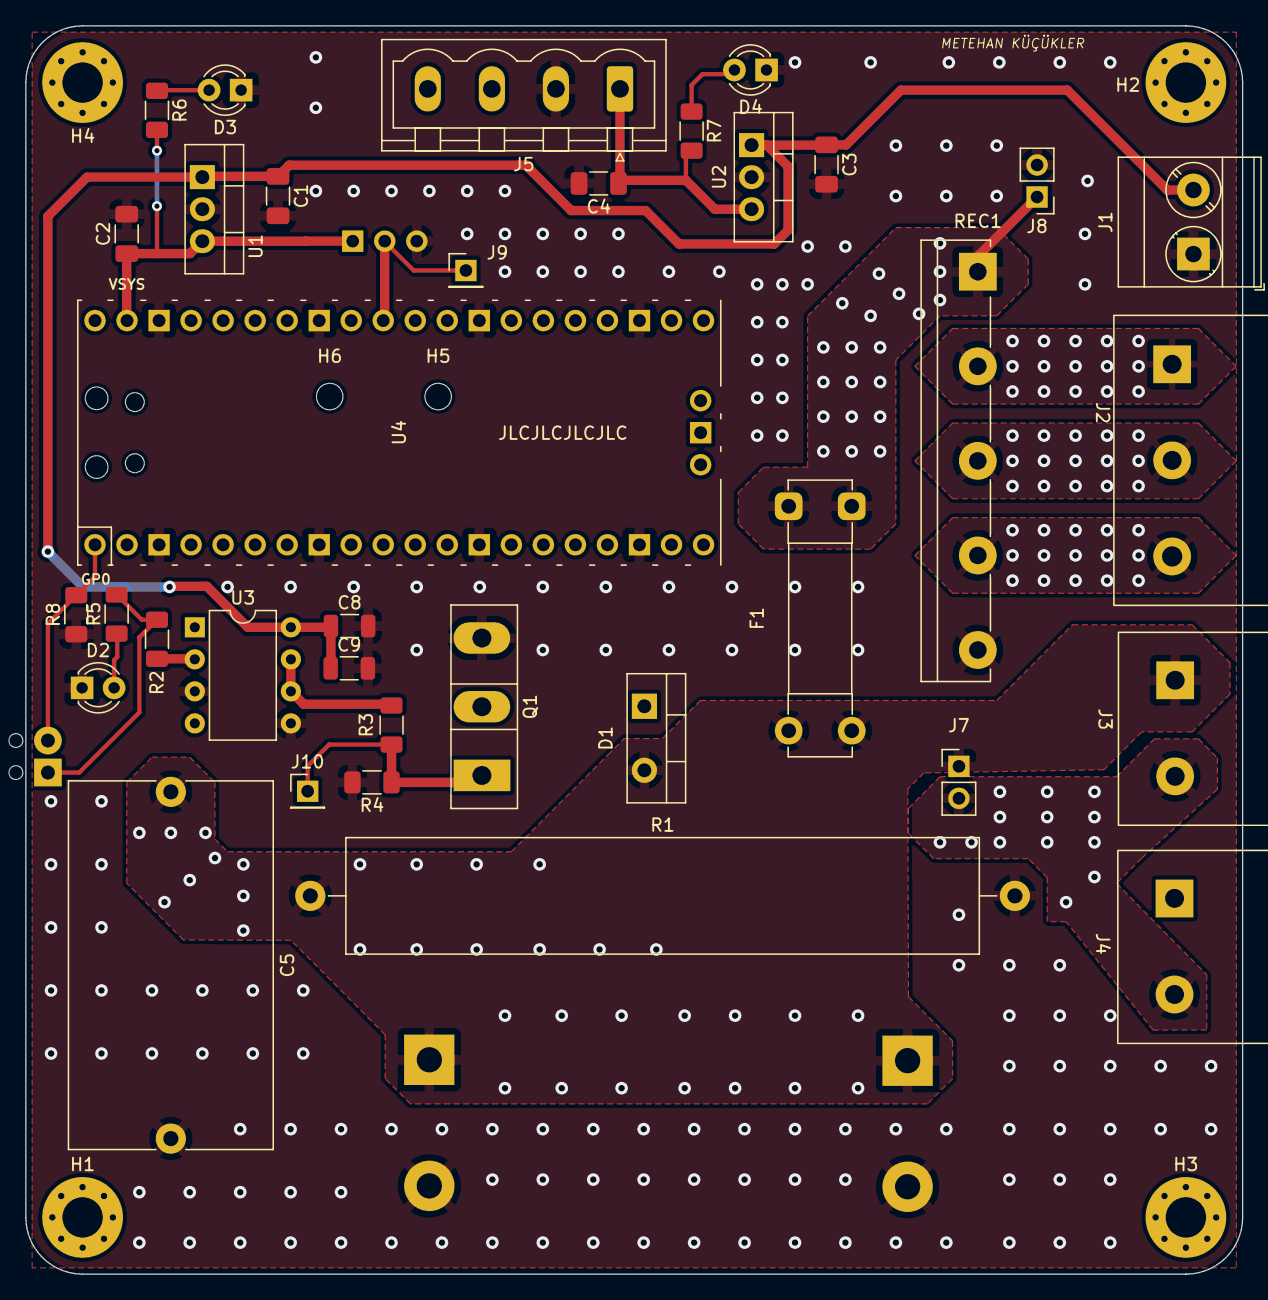
[picture p55: board v3.kicad_pcb from above]

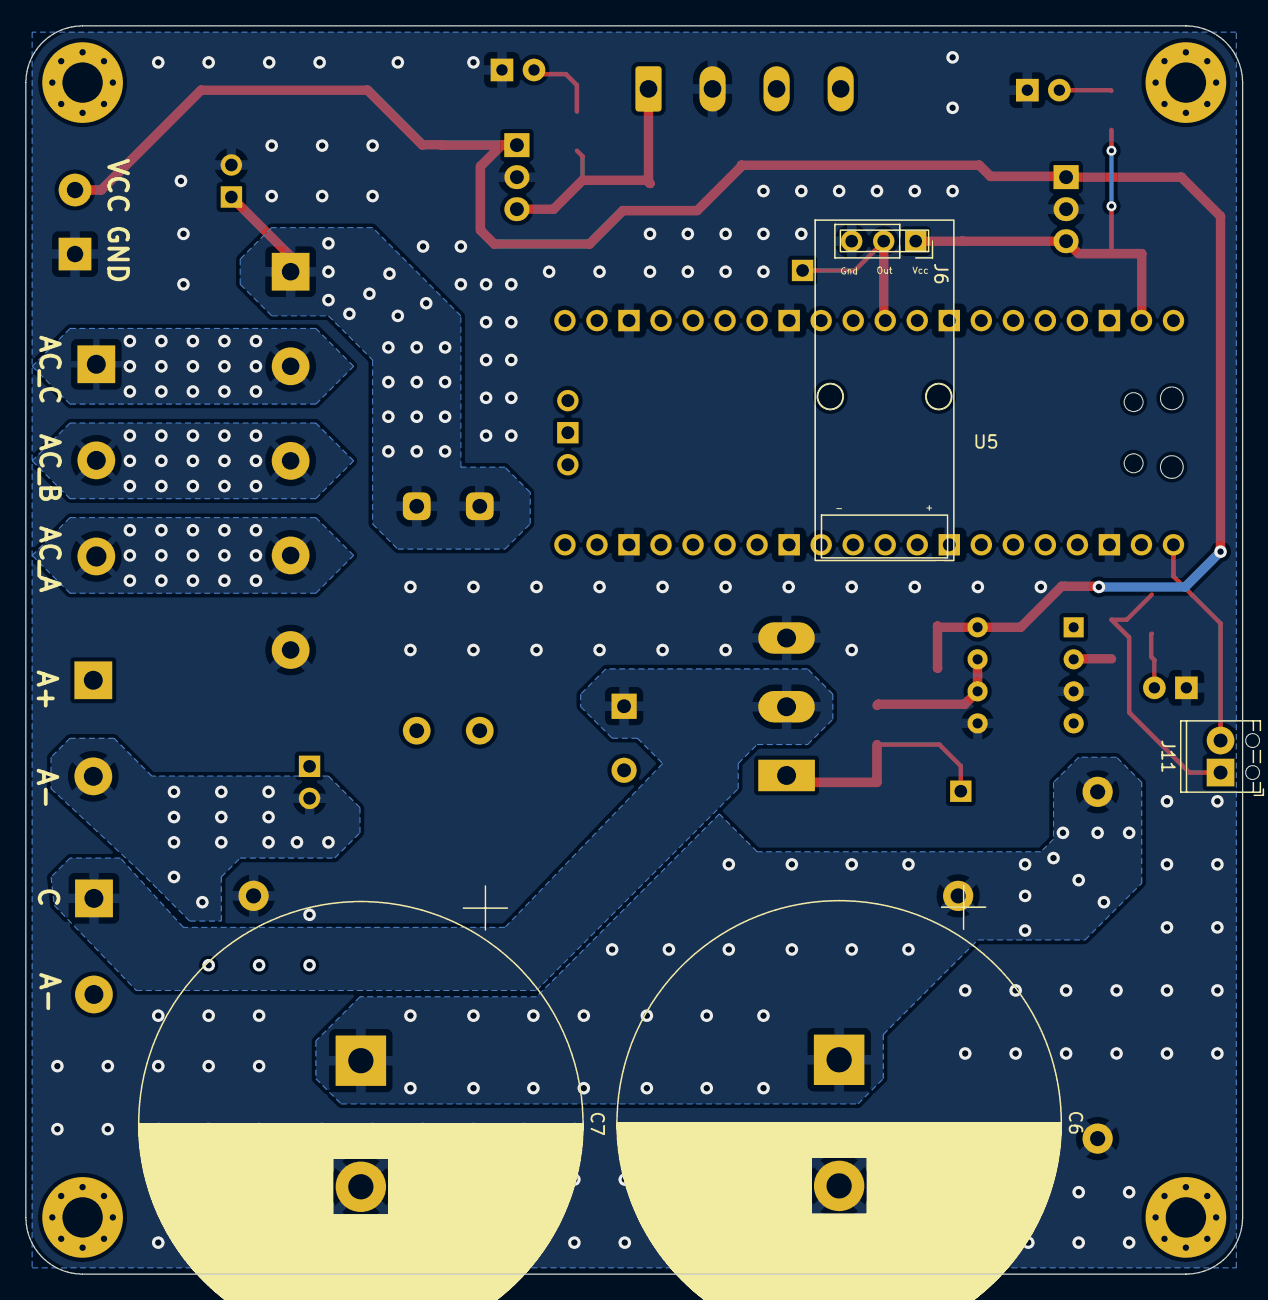
[picture p56: board v3.kicad_pcb from below]

Board: 2 copper layers, 96.5 x 99.0 mm, 46 parts (5 on the bottom side), 20 nets.
