metehankk/MeteK-EE463_Project/Schematic/MeteK/v2/new-pcb.kicad_pcb

## KiCad design Schematic/MeteK/v2/new-pcb.kicad_pcb (2022-12-28, an earlier design)

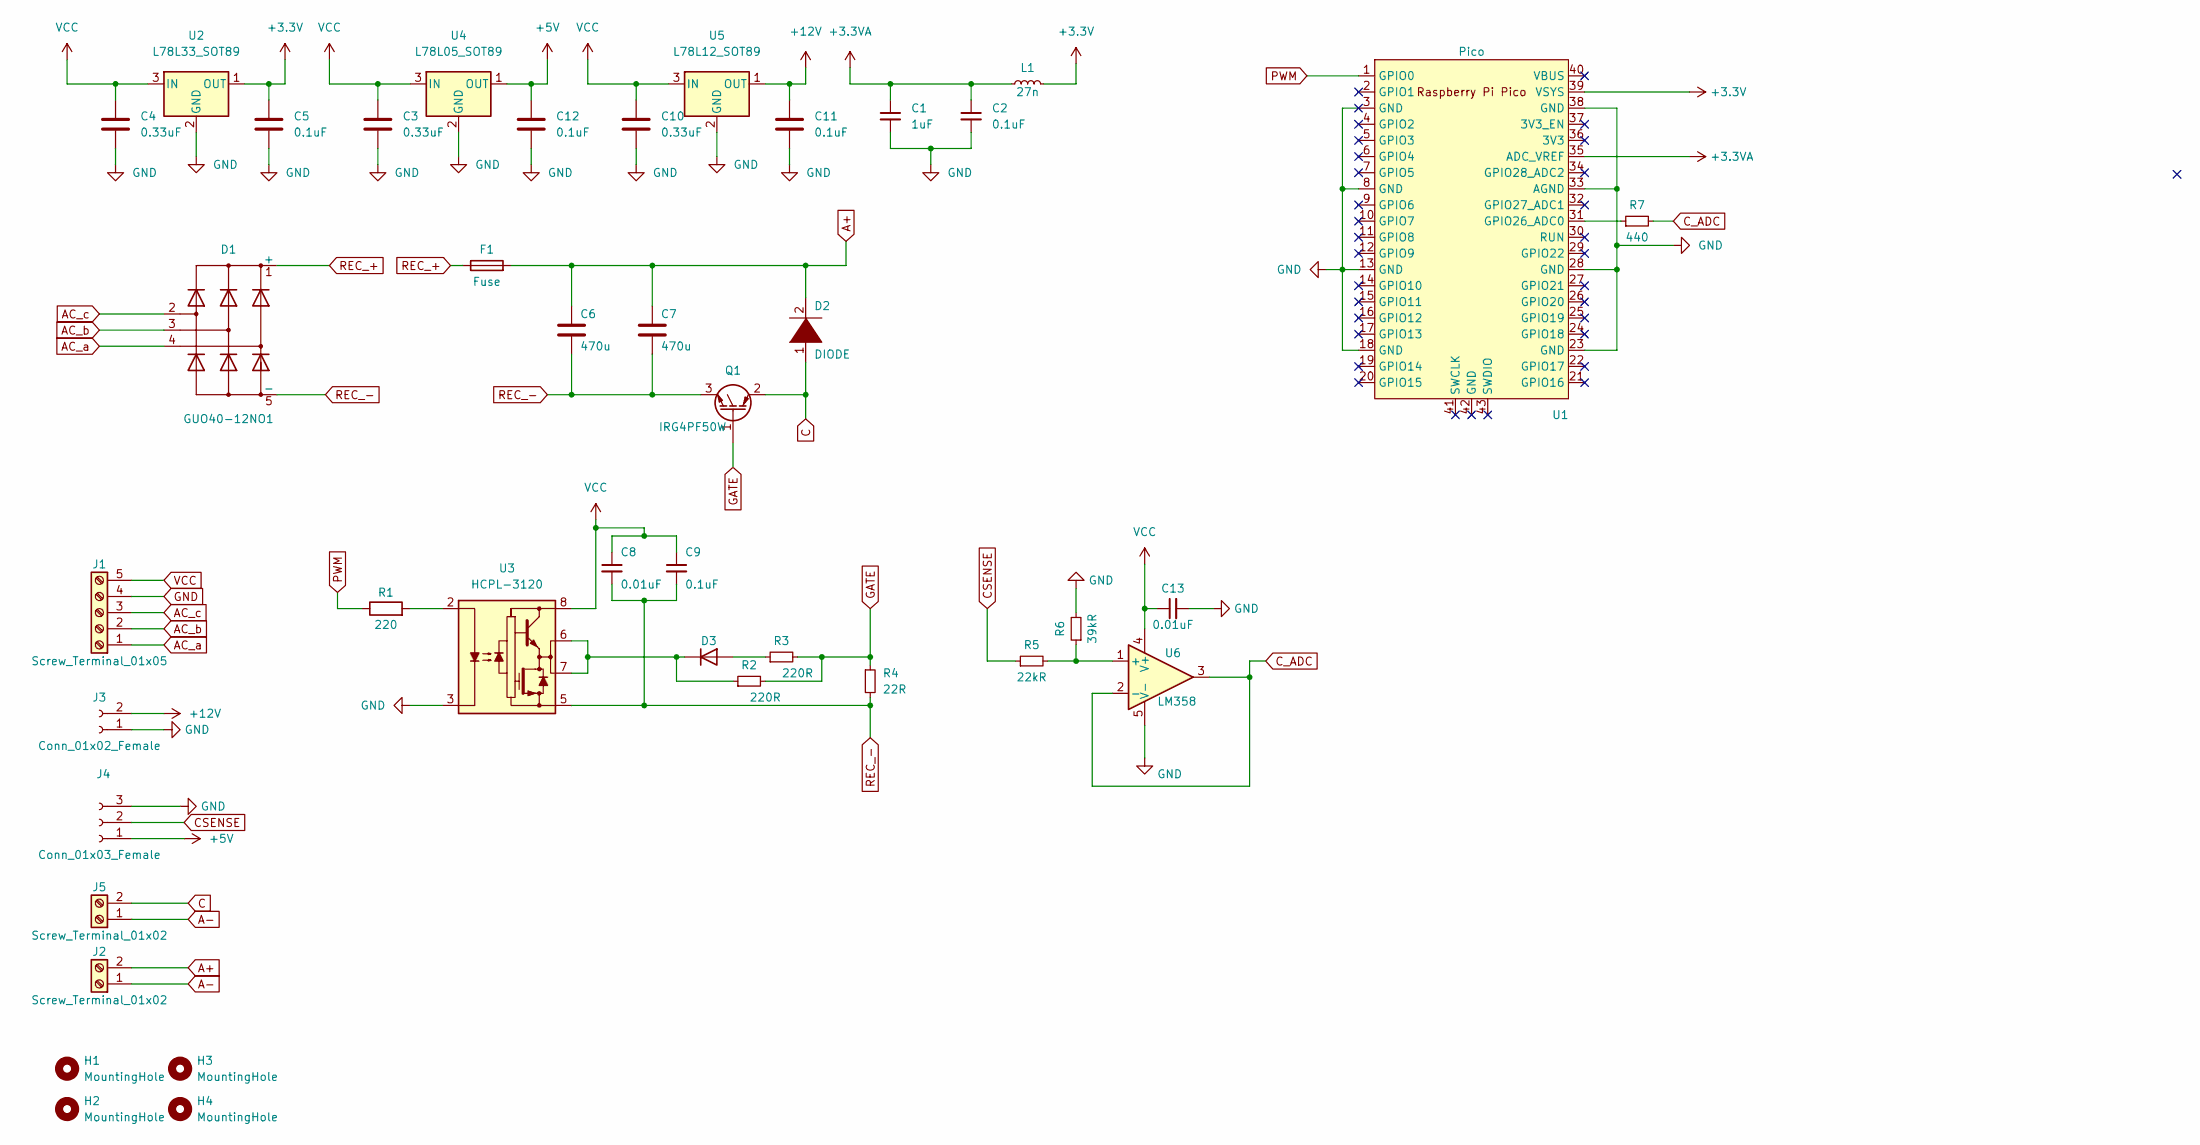
[picture p57: schematic new-pcb.kicad_sch]

Parts:
C1: 1uF; C_1206_3216Metric
C2, C5, C9, C11, C12: 0.1uF; C_1206_3216Metric
C3, C4, C10: 0.33uF; C_1206_3216Metric
C6, C7: 470u; CP_Radial_D35.0mm_P10.00mm_SnapIn
C8, C13: 0.01uF; C_1206_3216Metric
D1: GUO40-12NO1; Diode_Bridge_IXYS_GUFP
D2: DIODE; TO-220-2_Vertical
D3: 1N4148; D_SMB
F1: Fuse; Fuseholder_Clip-5x20mm_Bel_FC-203-22_Lateral_P17.80x5.00mm_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
H1, H2, H3, H4: MountingHole; MountingHole_3.2mm_M3_Pad
J1: Screw_Terminal_01x05; TerminalBlock_Phoenix_MKDS-3-5-5.08_1x05_P5.08mm_Horizontal
J2, J5: Screw_Terminal_01x02; TerminalBlock_Phoenix_MKDS-3-2-5.08_1x02_P5.08mm_Horizontal
J3: Conn_01x02_Female; PinHeader_1x02_P2.54mm_Vertical
J4: Conn_01x03_Female; PinSocket_1x03_P2.54mm_Vertical
L1: 27n; L_1206_3216Metric
Q1: IRG4PF50W; TO-247-3_Vertical
R1: 220; R_0603_1608Metric
R2, R3: 220R; R_0805_2012Metric
R4: 22R; R_0805_2012Metric
R5: 22kR; R_0805_2012Metric
R6: 39kR; R_0805_2012Metric
R7: 440; R_0805_2012Metric
U1: Pico; RPi_Pico_SMD_TH
U2: L78L33_SOT89; SOT-89-3
U3: HCPL-3120; DIP-8_W7.62mm
U4: L78L05_SOT89; SOT-89-3
U5: L78L12_SOT89; SOT-89-3
U6: LM358; DIP-8_W7.62mm

Connections:
+3.3V: C5.1, L1.2, U1.39 (VSYS), U2.1 (OUT)
+3.3VA: C1.1, C2.1, L1.1, U1.35 (ADC_VREF)
+5V: C12.1, J4.1, U4.1 (OUT)
+12V: C11.1, J3.2, U5.1 (OUT)
A+: C6.1, C7.1, D2.2 (A), F1.2, J2.2
A-: J2.1, J5.1
AC_a: D1.4, J1.1
AC_b: D1.3, J1.2
AC_c: D1.2, J1.3
C: D2.1 (K), J5.2, Q1.2 (C)
CSENSE: J4.2, R5.1
C_ADC: R7.2, U6.2 (-), U6.3
GATE: Q1.1 (G), R2.2, R3.2, R4.1
GND: C1.2, C2.2, C3.2, C4.2, C5.2, C10.2, C11.2, C12.2, C13.2, J1.4, J3.1, J4.3, R6.2, U1.3 (GND), U1.8 (GND), U1.13 (GND), U1.18 (GND), U1.23 (GND), U1.28 (GND), U1.33 (AGND), U1.38 (GND), U2.2 (GND), U3.3 (C), U4.2 (GND), U5.2 (GND), U6.5 (V-)
unnamed: D3.1 (K), R2.1, U3.6 (VO), U3.7 (VO)
unnamed: D3.2 (A), R3.1
unnamed: R1.2, U3.2 (A)
unnamed: R5.2, R6.1, U6.1 (+)
unnamed: R7.1, U1.31 (GPIO26_ADC0)
PWM: R1.1, U1.1 (GPIO0)
REC_+: D1.1 (+), F1.1
REC_-: C6.2, C7.2, C8.2, C9.2, D1.5 (-), Q1.3 (E), R4.2, U3.5 (VEE)
VCC: C3.1, C4.1, C8.1, C9.1, C10.1, C13.1, J1.5, U2.3 (IN), U3.8 (VCC), U4.3 (IN), U5.3 (IN), U6.4 (V+)

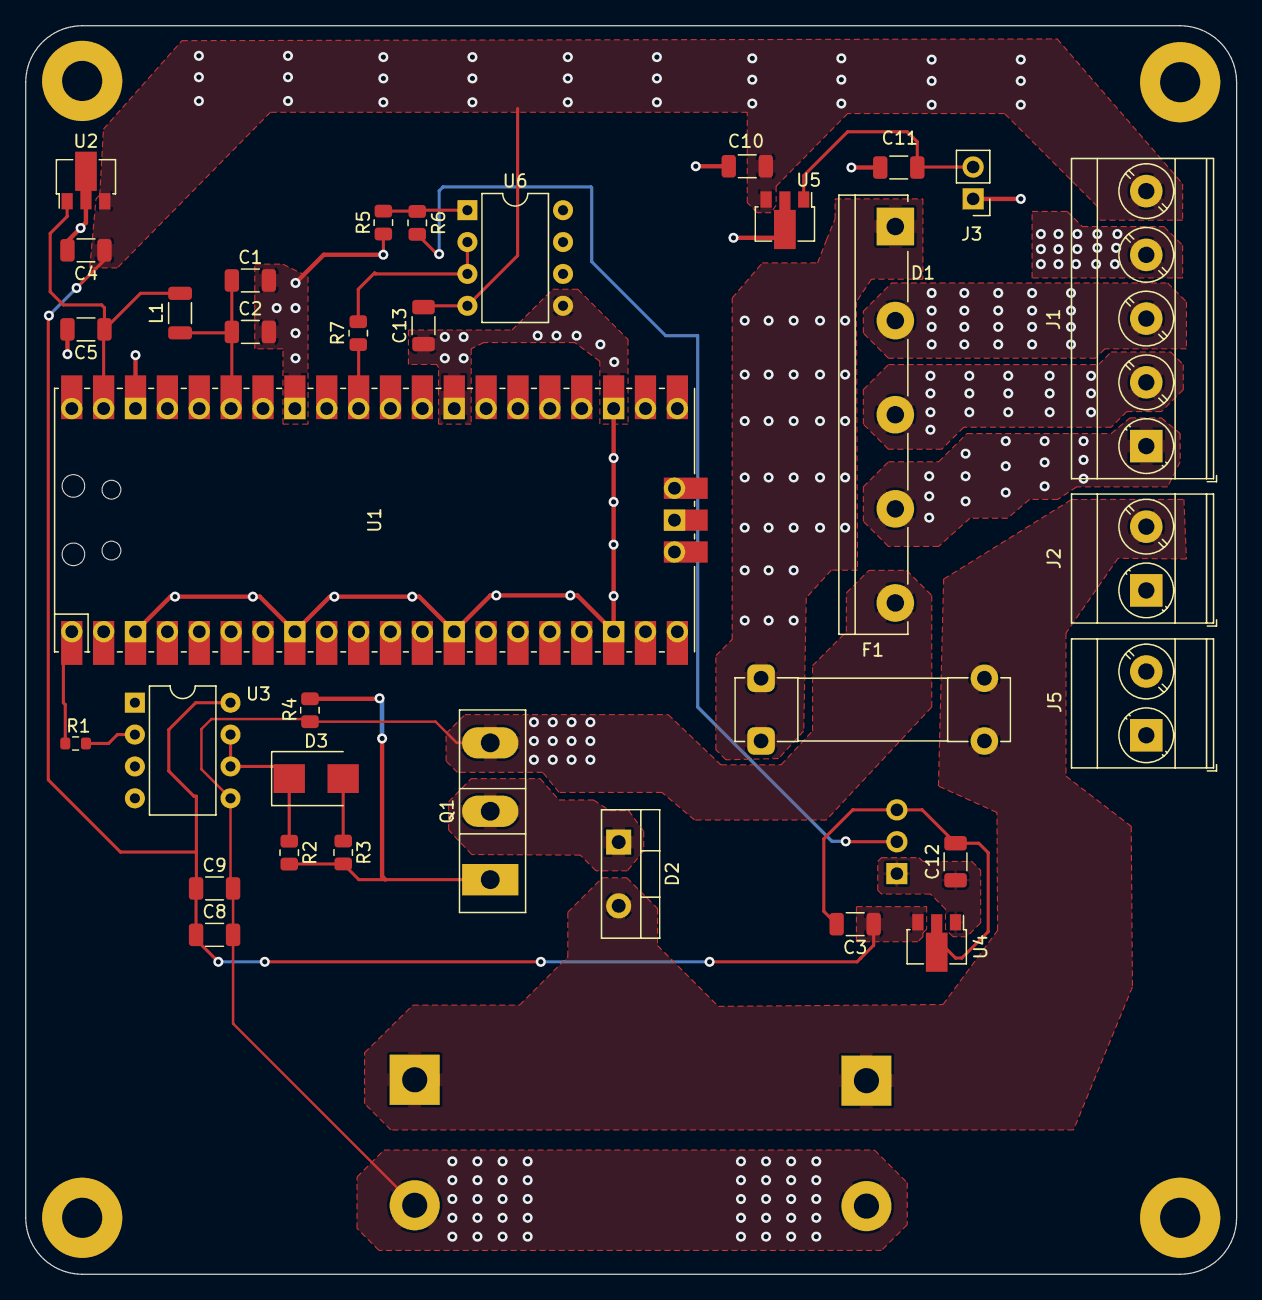
[picture p58: board new-pcb.kicad_pcb from above]

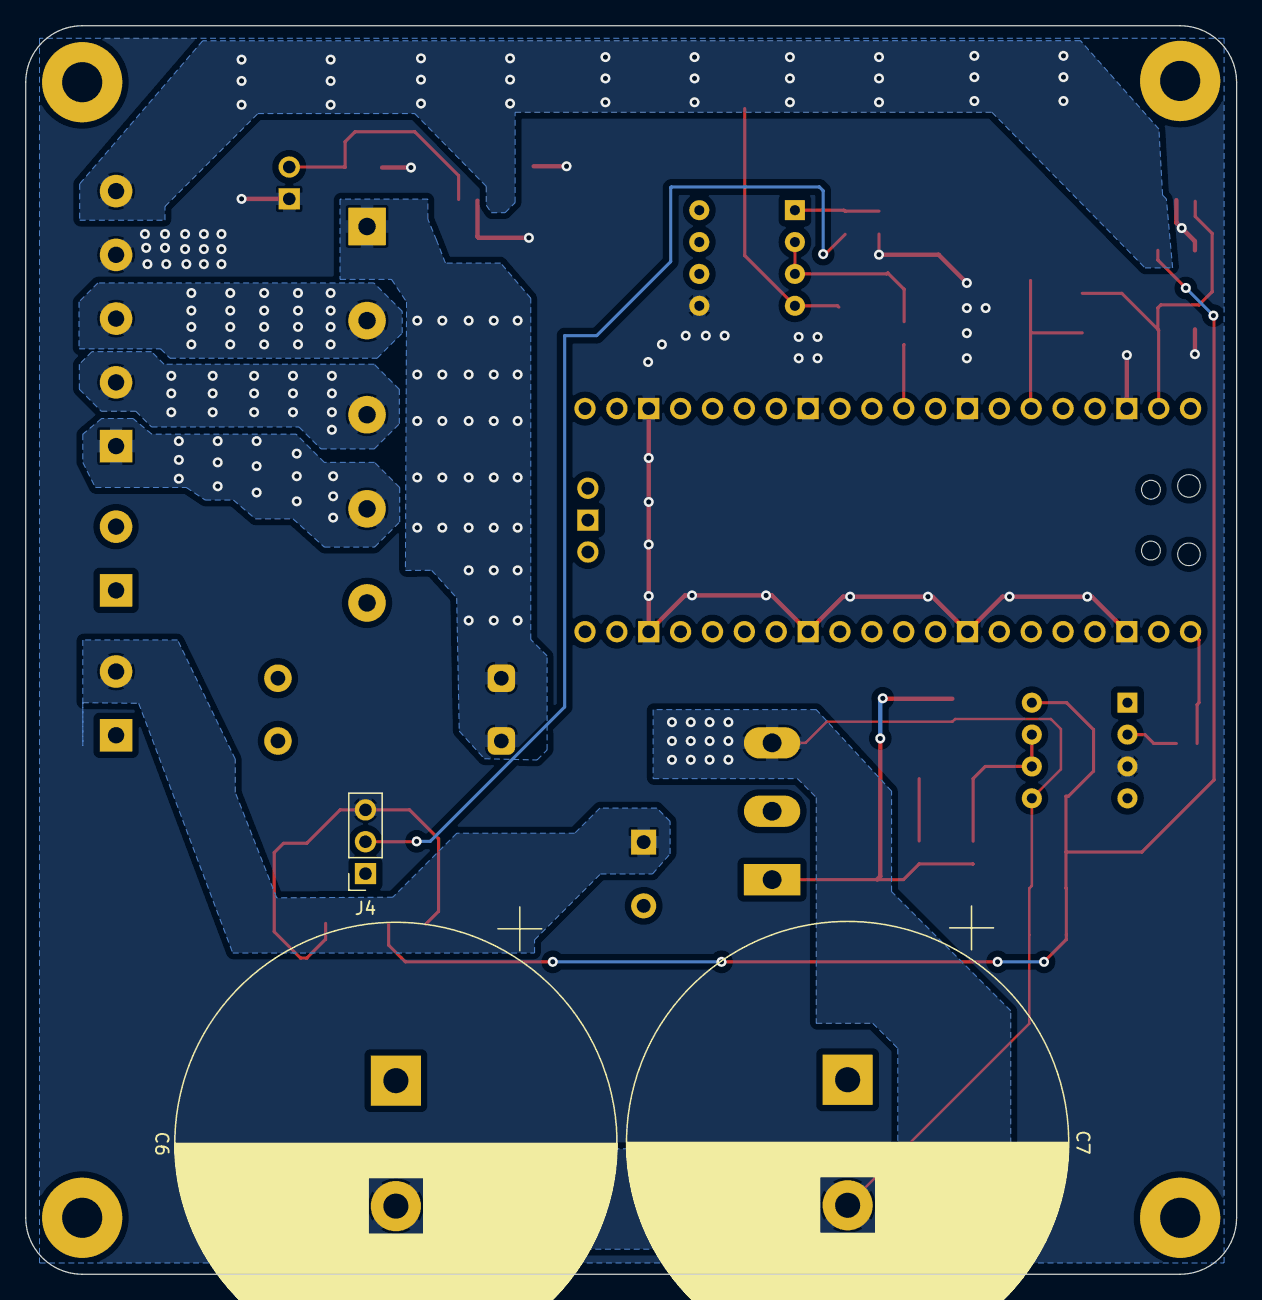
[picture p59: board new-pcb.kicad_pcb from below]

Board: 2 copper layers, 96.5 x 99.5 mm, 41 parts (3 on the bottom side), 23 nets.
