metehankk/MeteK-EE463_Project/(commit log)

2022-12-12 Schottky diode changed to fast diode.
2022-12-12 Closed-loop armature current control added. Simulink schematic is cleaned up. Current sensing w/opamp and opto-coupler test in LTspice are done.
2022-12-14 Components are selected. LTspice implementation is added with specific components.
    [MeteK.kicad_pcb, MeteK.kicad_sch]
2022-12-19 Gate driver fixes. Initial KiCad schematic and PCB design trials. Updates on components.
    [MeteK.kicad_pcb, MeteK.kicad_sch]
2022-12-22 further tests on schematic and pcb layout.
    [MeteK.kicad_pcb, MeteK.kicad_sch]
2022-12-28 Schematic and PCB layout are finalized.
    [MeteK.kicad_pcb, MeteK.kicad_sch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]
2023-01-02 Initial case design are created.
2023-01-05 Case design is finalized.
    [back.stl, bottom.stl, cubes.stl, front.stl, left.stl, pcb-mount.stl, right.stl, top.stl]
2023-01-24 Final commit before last submission.
    [top.stl]
